SpaceJockey/MRSD-Team-B/ROS/src/spacejockey/resources/clean_map.png

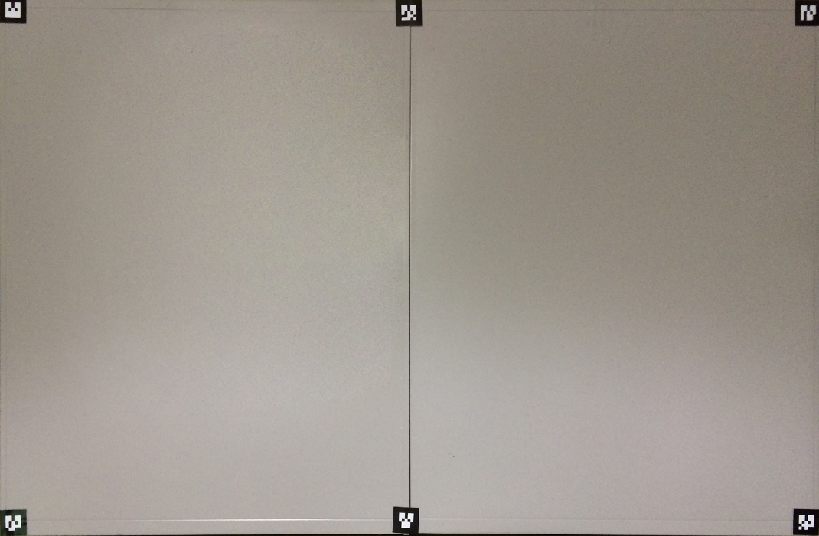
ROS/src/spacejockey/resources/clean_map.png
