SpaceJockey/MRSD-Team-B/ROS/src/spacejockey/resources/dirty_map.png

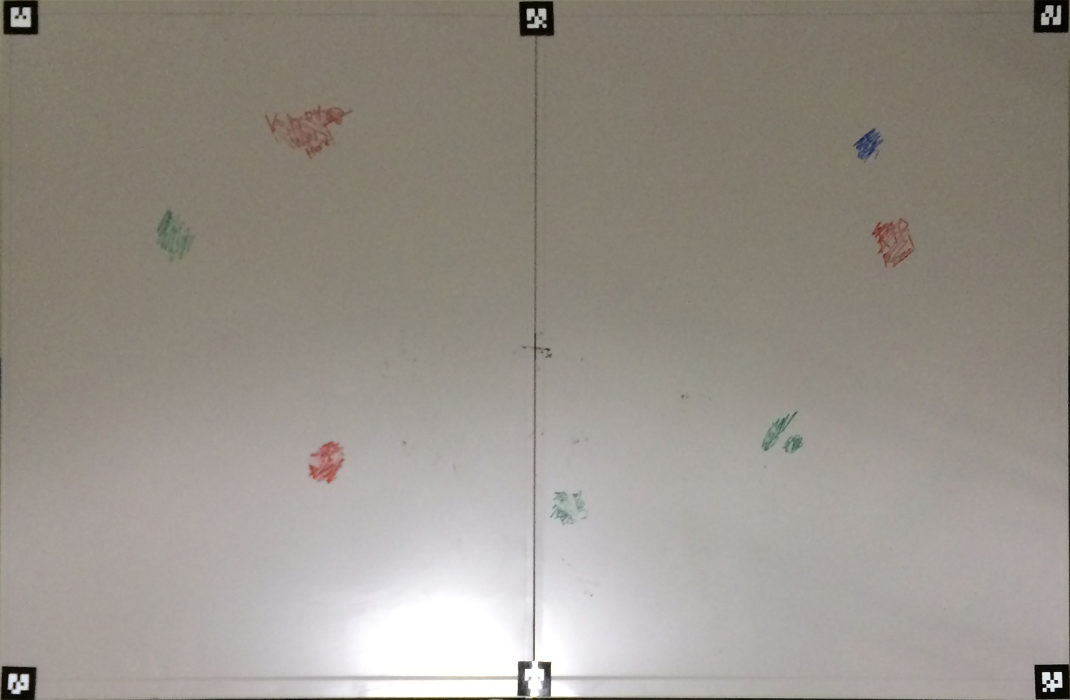
ROS/src/spacejockey/resources/dirty_map.png
