SpaceJockey/MRSD-Team-B/README.md

MRSD-Team-B
===========

The best team is sometimes the B team...
