SpaceJockey/MRSD-Team-B/CAD/Markers/mark_0_1.png

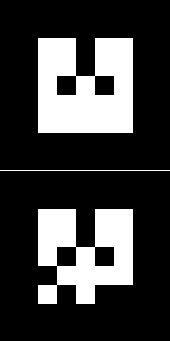
CAD/Markers/mark_0_1.png
