SpaceJockey/MRSD-Team-B/CAD/Markers/mark_2_3.png

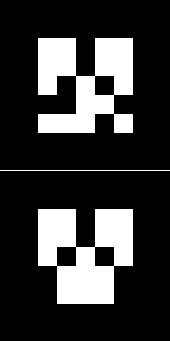
CAD/Markers/mark_2_3.png
