SpaceJockey/MRSD-Team-B/CAD/Markers/mark_4_5.png

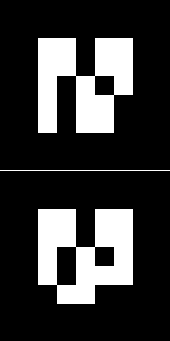
CAD/Markers/mark_4_5.png
