SpaceJockey/MRSD-Team-B/ROS/src/spacejockey/resources/ar_mask.png

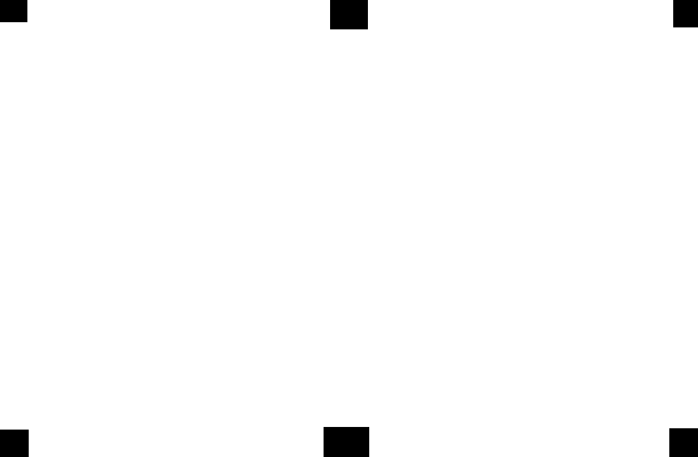
ROS/src/spacejockey/resources/ar_mask.png
