SpaceJockey/MRSD-Team-B/ROS/src/spacejockey/resources/vignette.png

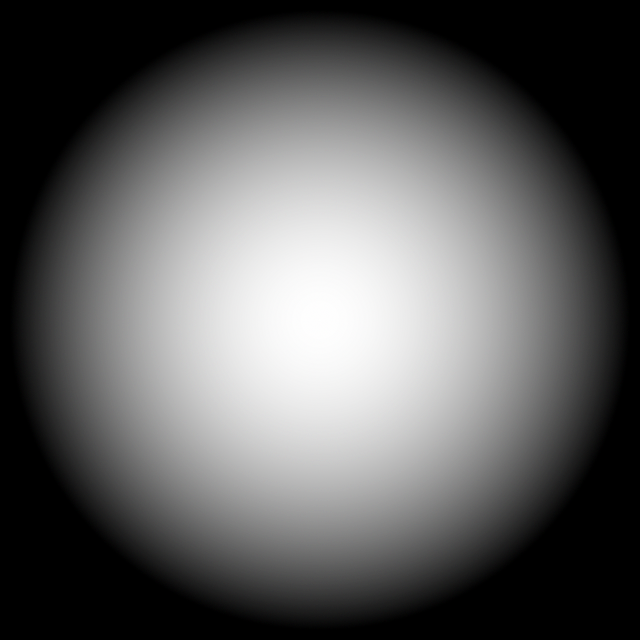
ROS/src/spacejockey/resources/vignette.png
