SpaceJockey/MRSD-Team-B/Eagle/PDM/PDM_BOM.xlsx

Qty | Label | Value | Description | Package | Digi-Key Part # | Link
8 | CAM*, DUE, SERVO* |  | Molex 5566-2 Mini FIT connector 2 poles | 5566-2 | WM3843-ND | http://www.digikey.com/product-detail/en/0039293026/WM3843-ND/2002650
10 | C1, C5-C10 | 10uF | Decoupling Capacitors | C1206K | 399-8269-1-ND | http://www.digikey.com/product-detail/en/T491A106K016AT/399-8269-1-ND/3471992
3 | D1 | 8.5V | TVS Diode | SMBJ | SMBJ8.5ALFCT-ND | http://www.digikey.com/product-detail/en/SMBJ8.5A/SMBJ8.5ALFCT-ND/762818
4 | D2 | 3.3V | Zener Diode | SOD80C | 568-6264-1-ND | http://www.digikey.com/product-detail/en/BZV55-C3V3,115/568-6264-1-ND/2531551
8 | F_* |  | Automotive Fuse Holder, PCB Mount | MINI-ATO | F065-ND | http://www.digikey.com/product-detail/en/01530008Z/F065-ND/183334
8 | LED* |  | Green Status LED | SML1206 | 160-1169-1-ND | http://www.digikey.com/product-detail/en/LTST-C150GKT/160-1169-1-ND/269241
10 | R1-6,8 | 1K | RESISTOR, American symbol | R1206 | RMCF1206JT1K00CT-ND | http://www.digikey.com/product-detail/en/RMCF1206JT1K00/RMCF1206JT1K00CT-ND/1942786
4 | R7 | 1.54K | RESISTOR, American symbol | R1206 | P1.54KFCT-ND | http://www.digikey.com/product-detail/en/ERJ-8ENF1541V/P1.54KFCT-ND/89668
5 | BATT_FUSE | 10 A | Mini Automotive Fuse | MINI-ATO | F991-ND | http://www.digikey.com/product-detail/en/0297010.WXNV/F991-ND/146591
5 | DUE_FUSE | 2 A | Mini Automotive Fuse | MINI-ATO | F986-ND | http://www.digikey.com/product-detail/en/0297002.WXNV/F986-ND/124900
5 | SERVO_FUSE | 7.5 A | Mini Automotive Fuse | MINI-ATO | F990-ND | http://www.digikey.com/product-detail/en/029707.5WXNV/F990-ND/146586
2 | BATT* |  | XT60 Hobby LiPo Connector (Amazon) | XT60 Connector | N/A | N/A
1 | BAT_MON |  | .025" post Header (MRSD Stock) | TSW-101-02-S-S | N/A | N/A
2 | C2-3 | 330uF 10V | Electrolytic Capacitor (in MRSD Stock) | TT5D11 | N/A | N/A
N/A | U1-3 |  | L7805 Regulator (MRSD Stock) | TO-220 | N/A | N/A
