SpaceJockey/MRSD-Team-B/CAD/SolidWorks/Chassis Parts/CenterJoint.SLDASM

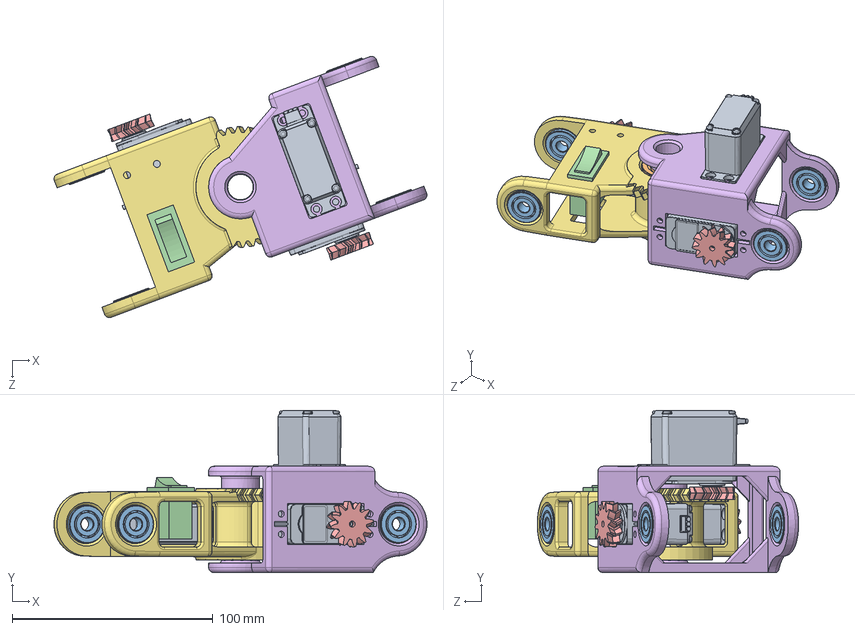
[picture p8: CAD file, 2014-05-08]
CAD/SolidWorks/Chassis Parts/CenterJoint.SLDASM
185.8 x 80.7 x 130.2 mm
Hitec HS-5496 x 3
6455K230 x 2
6455K130 x 4
1091-1013-ND
VGearServo x 3
CenterJointB
CenterJoinA
