SpaceJockey/MRSD-Team-B/CAD/SolidWorks/Linear Actuator/RackShaft.SLDASM

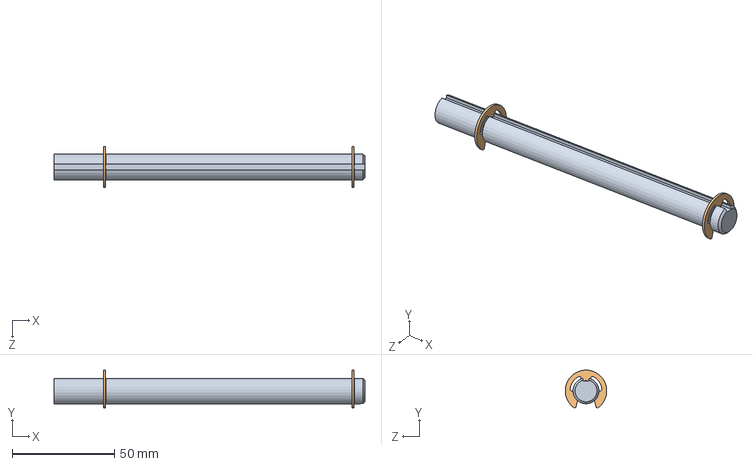
[picture p9: CAD file, 2014-05-08]
CAD/SolidWorks/Linear Actuator/RackShaft.SLDASM
152.4 x 18.5 x 20.3 mm
1570K420
97431A340 x 2
