SpaceJockey/MRSD-Team-B/CAD/SolidWorks/Space Jockey.SLDASM

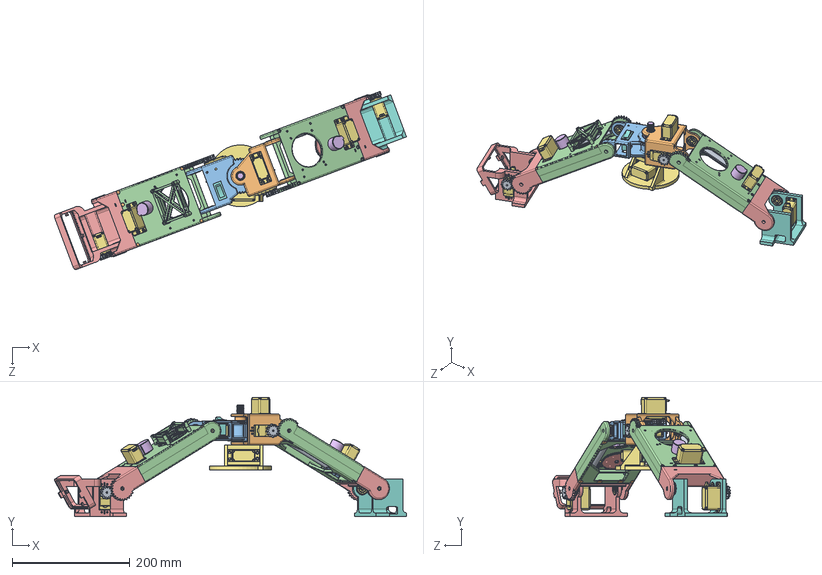
[picture p10: CAD file, 2014-05-08]
CAD/SolidWorks/Space Jockey.SLDASM
598.2 x 202.5 x 303.0 mm
1570K420 x 2
97431A340 x 4
5986K767 x 2
RSA48-HMG-36 x 2
SPBD48-24-96 x 2
3547S-1AA-502A-ND x 2
Hitec HS-5496 x 8
5986K66 x 2
1257K650 x 2
FixedEndJoin x 2
FreeEndJoin x 2
6455K230 x 2
6455K130 x 8
1091-1013-ND
VGearServo x 5
CenterJointB
CenterJoinA
BatteryBox x 2
CameraFoot
CenterFootAss^CenterFoot
EndFootB
