SpaceJockey/MRSD-Team-B/CAD/SolidWorks/Chassis Parts/BatteryBox.SLDASM

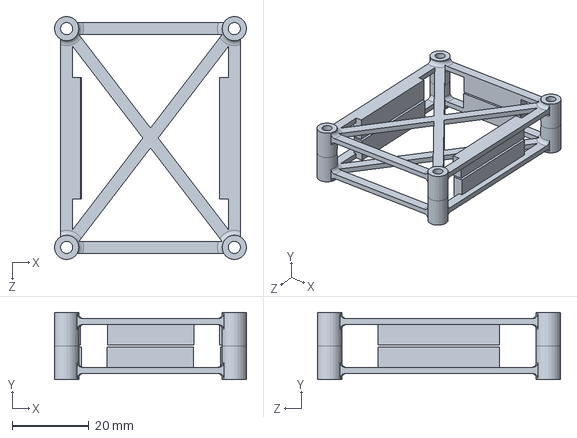
[picture p11: CAD file, 2014-05-08]
CAD/SolidWorks/Chassis Parts/BatteryBox.SLDASM
50.2 x 17.5 x 63.5 mm
BatteryBox x 2
