SpaceJockey/MRSD-Team-B/CAD/SolidWorks/Linear Actuator/FreeEndJoin.SLDASM

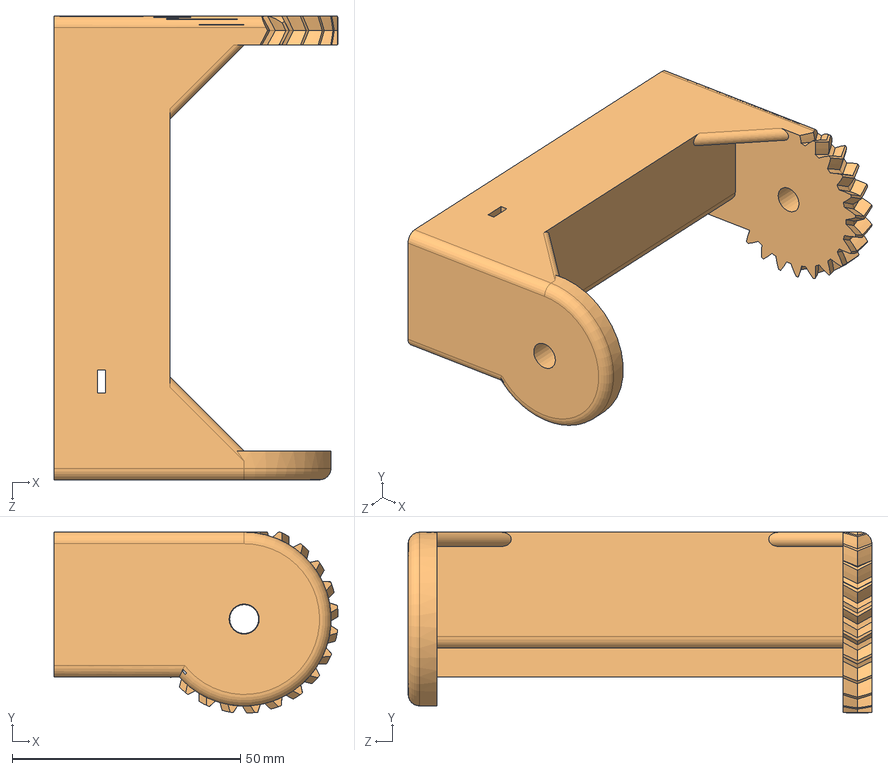
[picture p12: CAD file, 2014-05-08]
CAD/SolidWorks/Linear Actuator/FreeEndJoin.SLDASM
62.2 x 39.6 x 101.6 mm
