SpaceJockey/MRSD-Team-B/CAD/SolidWorks/Chassis Parts/CenterFoot.SLDASM

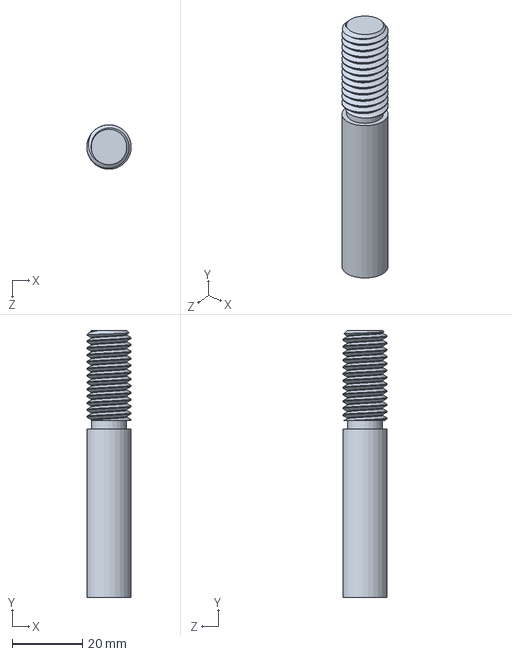
[picture p13: CAD file, 2014-05-07]
CAD/SolidWorks/Chassis Parts/CenterFoot.SLDASM
12.7 x 76.2 x 12.7 mm
