SpaceJockey/MRSD-Team-B/CAD/SolidWorks/Linear Actuator/Actuator.SLDASM

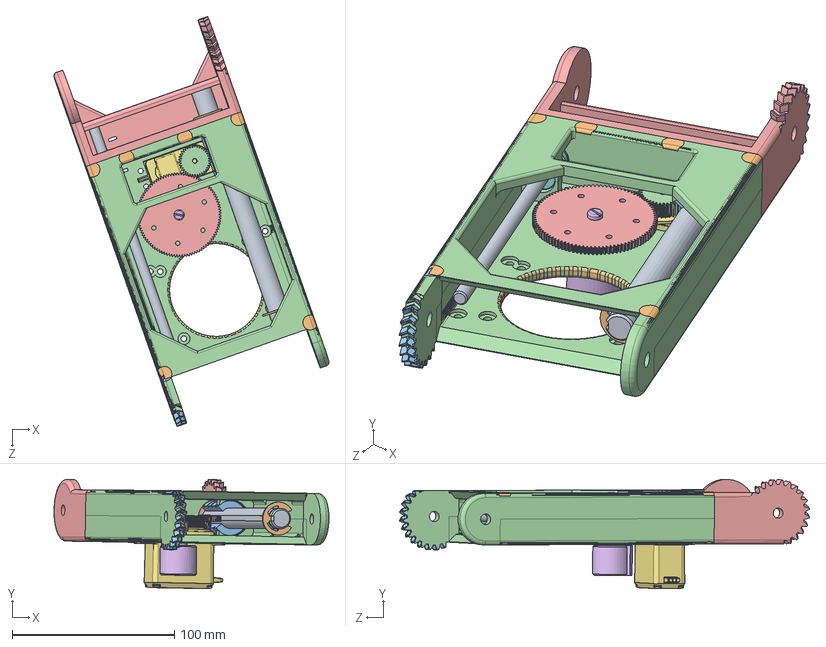
[picture p14: CAD file, 2014-05-08]
CAD/SolidWorks/Linear Actuator/Actuator.SLDASM
169.3 x 67.3 x 252.5 mm
1570K420
97431A340 x 2
5986K767
RSA48-HMG-36
SPBD48-24-96
3547S-1AA-502A-ND
Hitec HS-5496
5986K66
1257K650
FixedEndJoin
FreeEndJoin
