SpaceJockey/MRSD-Team-B/CAD/SolidWorks/Linear Actuator/FixedEndJoin.SLDASM

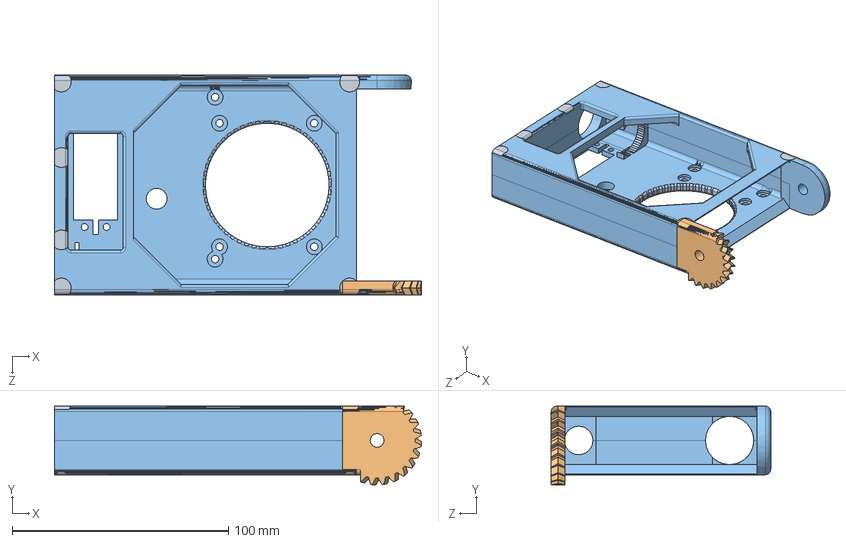
[picture p15: CAD file, 2014-04-10]
CAD/SolidWorks/Linear Actuator/FixedEndJoin.SLDASM
169.8 x 36.4 x 101.6 mm
