SpaceJockey/MRSD-Team-B/CAD/SolidWorks/Linear Actuator/FixedEndSplit.sldasm

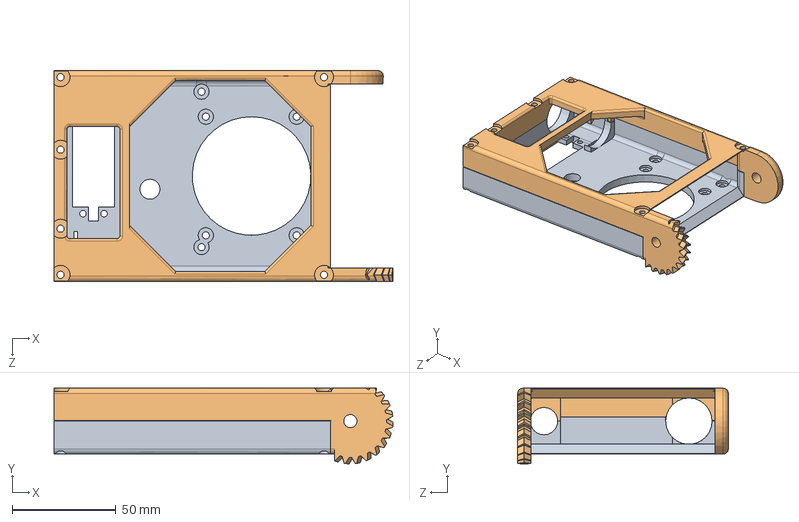
[picture p16: CAD file, 2014-03-10]
CAD/SolidWorks/Linear Actuator/FixedEndSplit.sldasm
163.4 x 36.4 x 101.6 mm
Top
Bottom
