SpaceJockey/MRSD-Team-B/CAD/SolidWorks/Chassis Parts/CenterJoinA.SLDASM

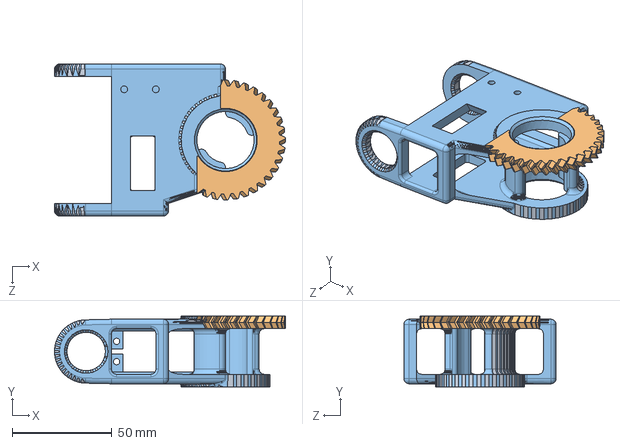
[picture p17: CAD file, 2014-03-31]
CAD/SolidWorks/Chassis Parts/CenterJoinA.SLDASM
115.8 x 35.6 x 76.2 mm
