SpaceJockey/MRSD-Team-B/CAD/SolidWorks/Test Parts/6-32-size.SLDPRT

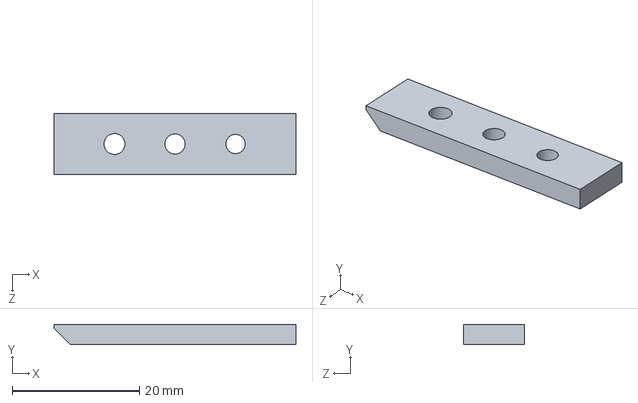
[picture p18: CAD file, 2014-03-10]
CAD/SolidWorks/Test Parts/6-32-size.SLDPRT
38.1 x 3.17 x 9.53 mm
