SpaceJockey/MRSD-Team-B/Eagle/PDM/Gerbers/GerbMerge/TeamB/TeamB.dxf

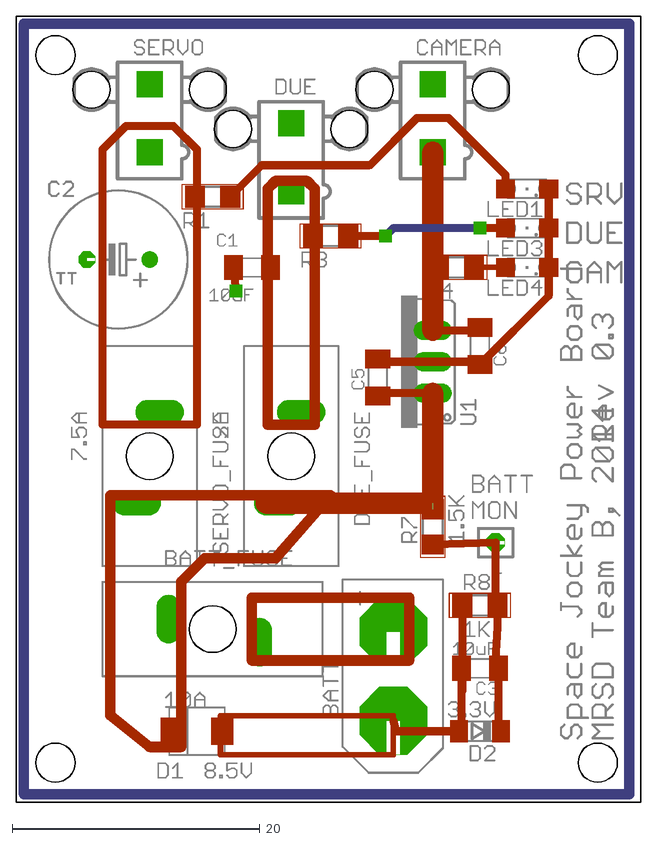
[picture p19: CAD file, 2014-02-17]
Eagle/PDM/Gerbers/GerbMerge/TeamB/TeamB.dxf
50.5 x 63.5
