SpaceJockey/MRSD-Team-B/CAD/SolidWorks/Test Parts/JointStub.SLDPRT

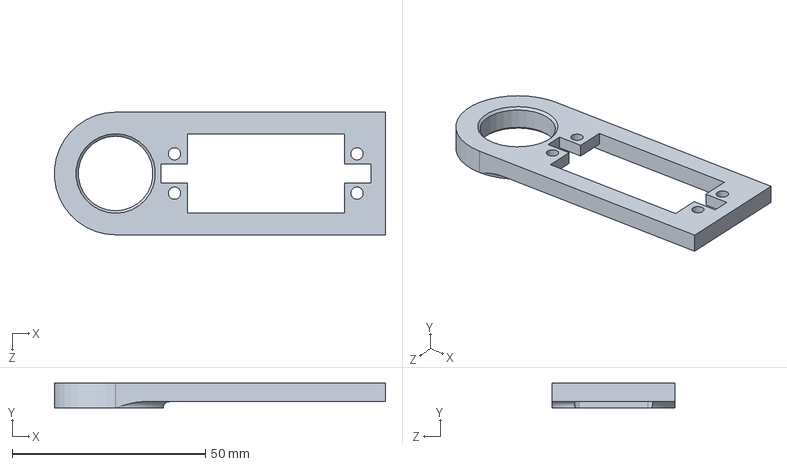
[picture p20: CAD file, 2014-03-10]
CAD/SolidWorks/Test Parts/JointStub.SLDPRT
85.7 x 6.35 x 31.8 mm
