SpaceJockey/MRSD-Team-B/CAD/SolidWorks/Chassis Parts/EndFoot.SLDPRT

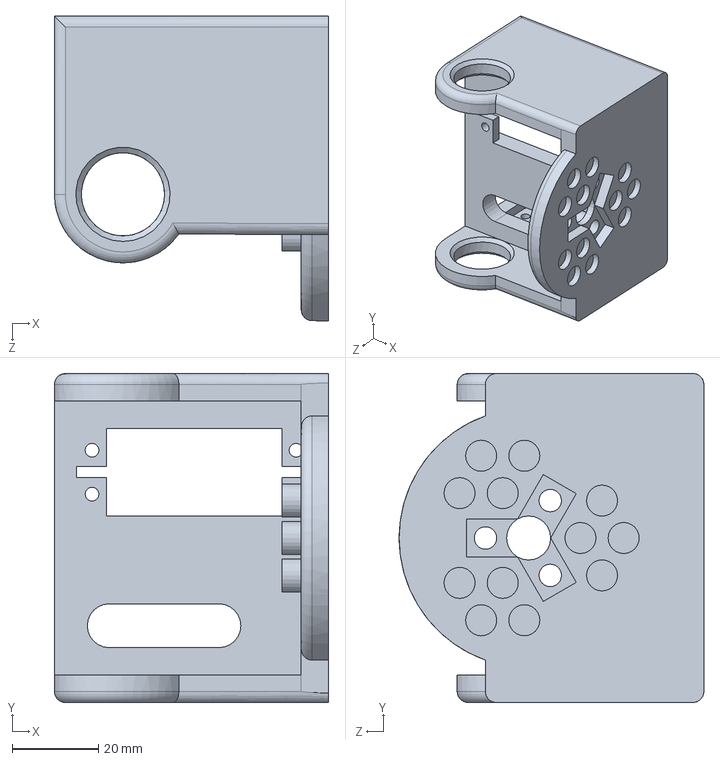
[picture p21: CAD file, 2014-04-28]
CAD/SolidWorks/Chassis Parts/EndFoot.SLDPRT
63.5 x 76.2 x 70.6 mm
