SpaceJockey/MRSD-Team-B/CAD/SolidWorks/Linear Actuator/FixedEnd.SLDPRT

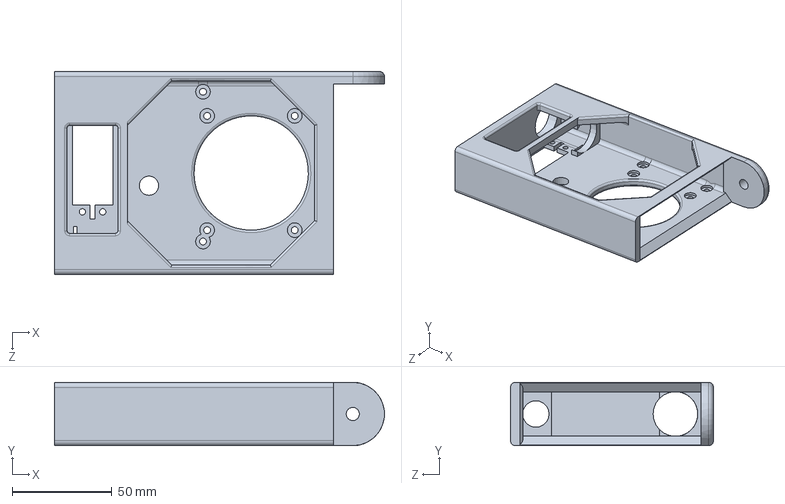
[picture p22: CAD file, 2014-04-10]
CAD/SolidWorks/Linear Actuator/FixedEnd.SLDPRT
165.1 x 31.8 x 101.6 mm
