SpaceJockey/MRSD-Team-B/CAD/SolidWorks/Chassis Parts/EndFootB.SLDPRT

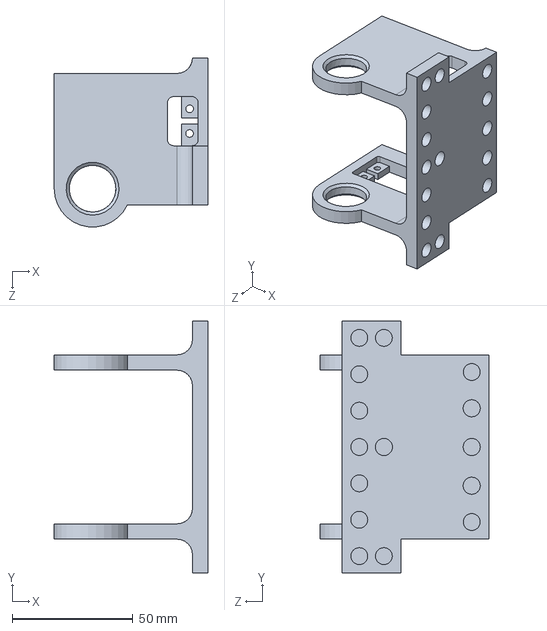
[picture p23: CAD file, 2014-04-28]
CAD/SolidWorks/Chassis Parts/EndFootB.SLDPRT
63.5 x 104.1 x 69.8 mm
