SpaceJockey/MRSD-Team-B/CAD/SolidWorks/Linear Actuator/Top.sldprt

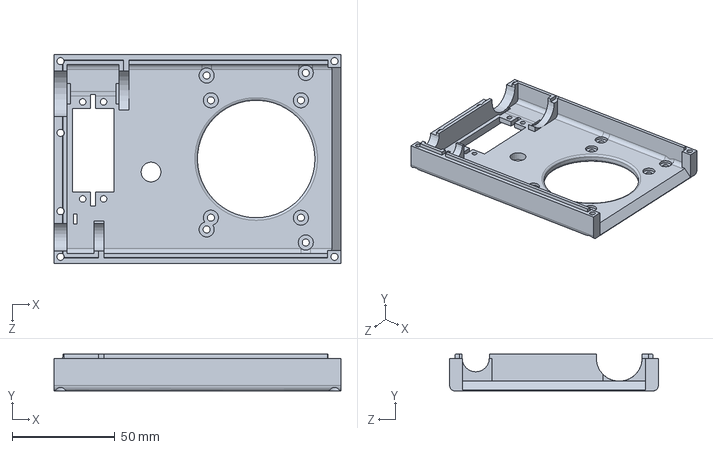
[picture p24: CAD file, 2014-04-10]
CAD/SolidWorks/Linear Actuator/Top.sldprt
139.7 x 17.9 x 101.6 mm
