SpaceJockey/MRSD-Team-B/CAD/SolidWorks/Chassis Parts/TriPeg.SLDPRT

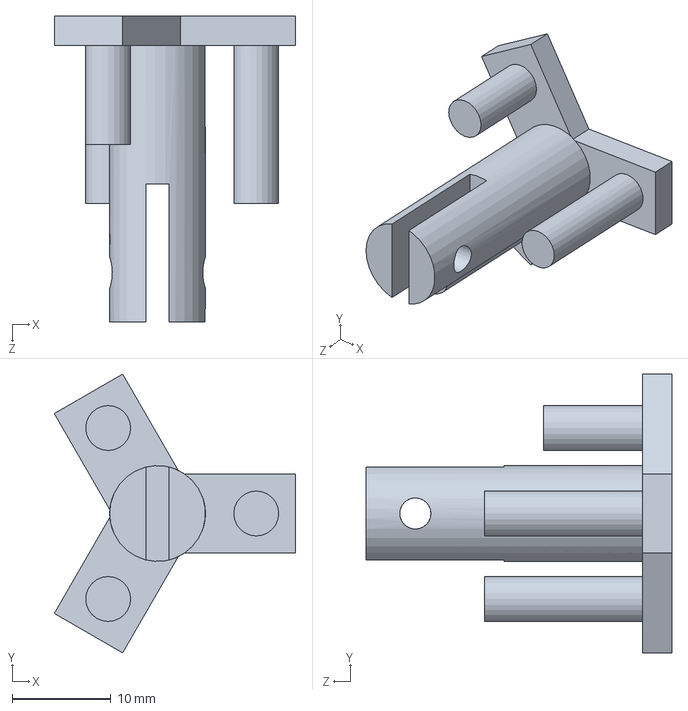
[picture p25: CAD file, 2014-04-28]
CAD/SolidWorks/Chassis Parts/TriPeg.SLDPRT
24.5 x 28.2 x 31.0 mm
