SpaceJockey/MRSD-Team-B/CAD/SolidWorks/Linear Actuator/FreeEnd.SLDPRT

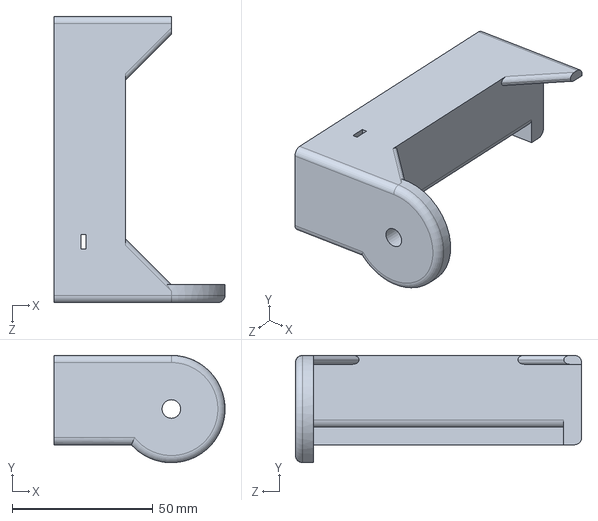
[picture p26: CAD file, 2014-04-05]
CAD/SolidWorks/Linear Actuator/FreeEnd.SLDPRT
60.7 x 38.1 x 101.6 mm
