SpaceJockey/MRSD-Team-B/CAD/SolidWorks/Chassis Parts/Peg4.SLDPRT

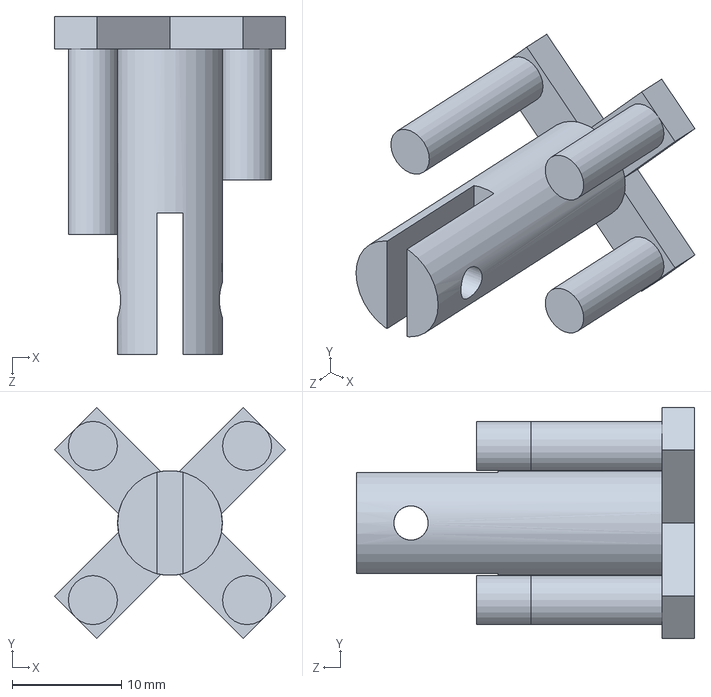
[picture p27: CAD file, 2014-04-28]
CAD/SolidWorks/Chassis Parts/Peg4.SLDPRT
21.2 x 21.2 x 31.0 mm
