SpaceJockey/MRSD-Team-B/CAD/SolidWorks/Linear Actuator/Bottom.sldprt

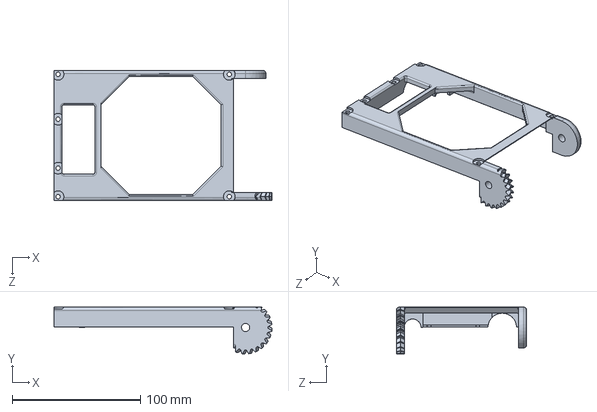
[picture p28: CAD file, 2014-04-05]
CAD/SolidWorks/Linear Actuator/Bottom.sldprt
169.8 x 36.4 x 101.6 mm
