SpaceJockey/MRSD-Team-B/CAD/SolidWorks/Chassis Parts/CameraMount.SLDPRT

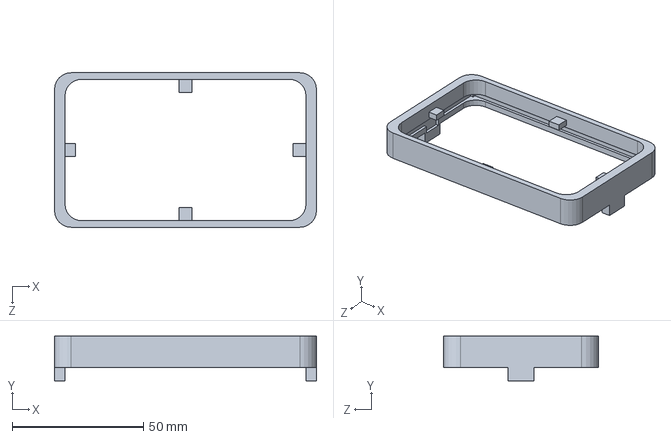
[picture p29: CAD file, 2014-04-28]
CAD/SolidWorks/Chassis Parts/CameraMount.SLDPRT
100.0 x 17.0 x 59.0 mm
