SpaceJockey/MRSD-Team-B/CAD/SolidWorks/Chassis Parts/CameraFoot.SLDPRT

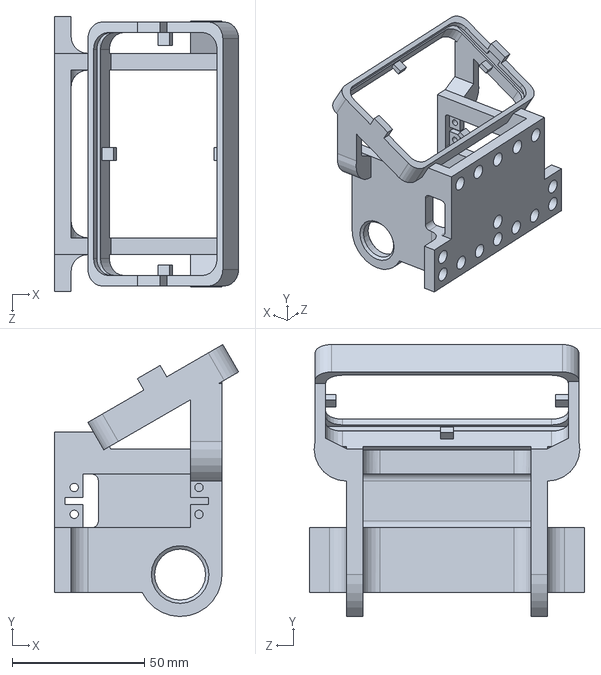
[picture p30: CAD file, 2014-04-28]
CAD/SolidWorks/Chassis Parts/CameraFoot.SLDPRT
69.8 x 103.0 x 104.1 mm
