SpaceJockey/MRSD-Team-B/CAD/SolidWorks/Chassis Parts/CenterJointA.SLDPRT

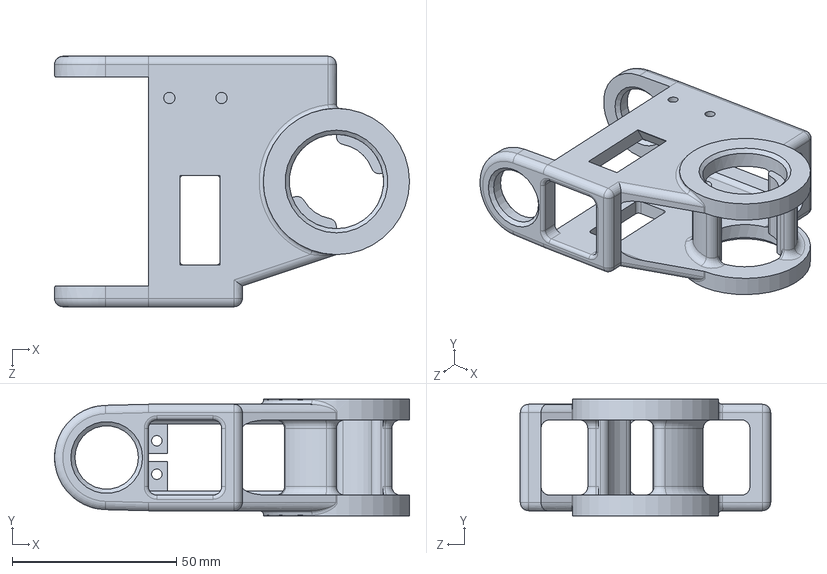
[picture p31: CAD file, 2014-03-31]
CAD/SolidWorks/Chassis Parts/CenterJointA.SLDPRT
107.9 x 35.6 x 76.2 mm
