SpaceJockey/MRSD-Team-B/CAD/SolidWorks/Chassis Parts/CenterJointB.SLDPRT

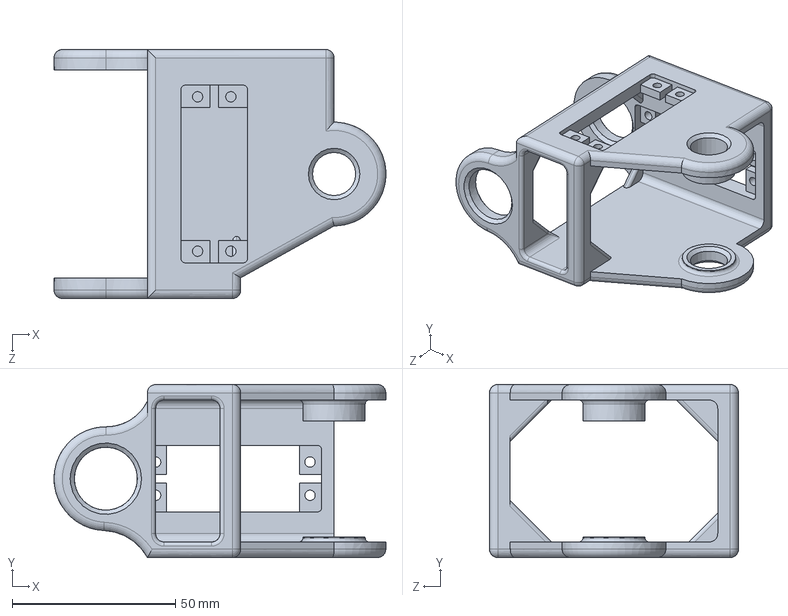
[picture p32: CAD file, 2014-03-12]
CAD/SolidWorks/Chassis Parts/CenterJointB.SLDPRT
101.6 x 53.0 x 76.2 mm
