SpaceJockey/MRSD-Team-B/(list of files, cad)

Other CAD files:
CAD/SolidWorks/Linear Actuator/TrimmedShaft.SLDASM
CAD/SolidWorks/Chassis Parts/BatteryBox.SLDPRT
CAD/SolidWorks/Chassis Parts/CenterJoinA.sldprt
CAD/SolidWorks/Chassis Parts/ScrewStub.SLDPRT
CAD/SolidWorks/Chassis Parts/Wood Washer.SLDPRT
CAD/SolidWorks/Linear Actuator/FixedEndJoin.sldprt
CAD/SolidWorks/Linear Actuator/FreeEndJoin.sldprt
CAD/SolidWorks/Linear Actuator/TrimmedShaft.SLDDRW
