SpaceJockey/MRSD-Team-B/Eagle/PDM/PDM.brd

## EAGLE design Eagle/PDM/PDM.brd (2014-02-17)

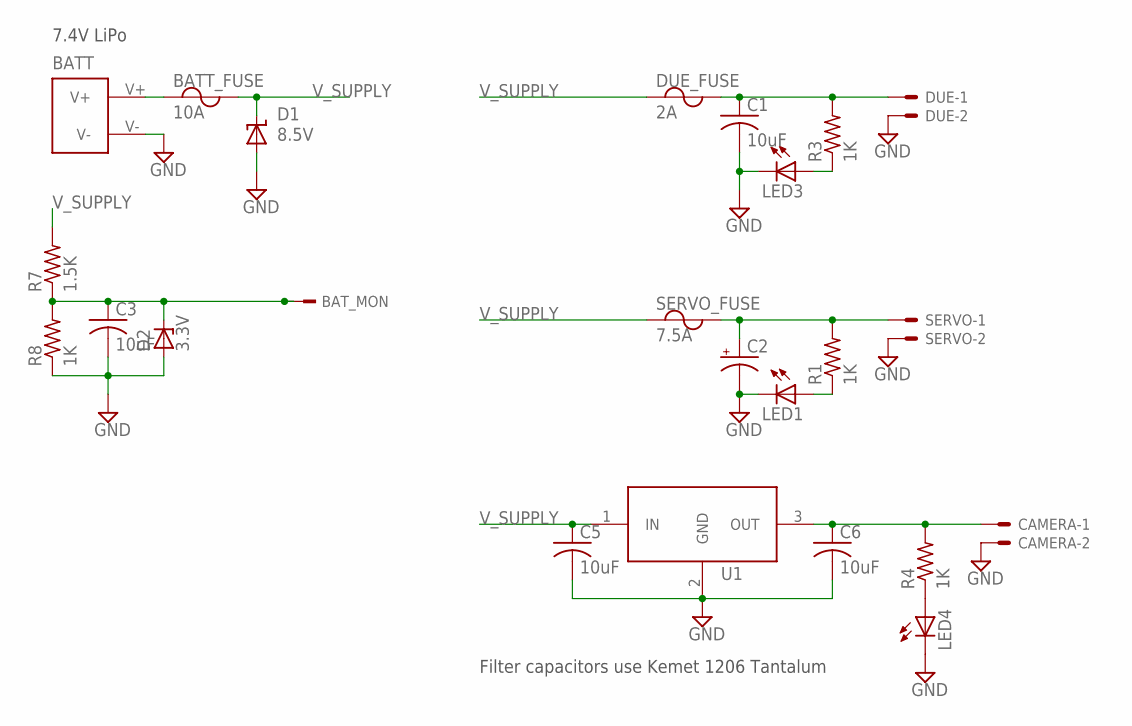
[picture p33: schematic PDM.sch]

Parts:
BATT: CON_XT60-; CON_XT60_PCB_MALE
BATT_FUSE: 10A; MINI_ATO
BAT_MON: TSW-101-02-S-S
C1, C3, C5, C6: 10uF; C1206K
C2: CPOL-USTT5D11; TT5D11
CAMERA: 5566-2
D1: 8.5V; SMBJ
D2: 3.3V; SOD80C
DUE: 5566-2
DUE_FUSE: 2A; MINI_ATO
LED1, LED3, LED4: LEDSML1206; SML1206
R1, R3, R4, R8: 1K; R1206
R7: 1.5K; R1206
SERVO: 5566-2
SERVO_FUSE: 7.5A; MINI_ATO
U1: MIC29150/29300/29500VERTICAL; TO220V

Connections:
GND: BATT.V-, C1.2, C2.-, C3.2, C5.2, C6.2, CAMERA.2, D1.A, D2.A, DUE.2, LED1.C, LED3.C, LED4.C, R8.1, SERVO.2, U1.2 (GND)
unnamed: BATT.V+, BATT_FUSE.P$2 (1)
unnamed: C1.1, DUE.1, DUE_FUSE.P$3 (2), R3.2
unnamed: LED1.A, R1.1
unnamed: C6.1, CAMERA.1, R4.2, U1.3 (OUT)
unnamed: LED3.A, R3.1
unnamed: LED4.A, R4.1
unnamed: C2.+, R1.2, SERVO.1, SERVO_FUSE.P$3 (2)
unnamed: BAT_MON.1, C3.1, D2.C, R7.1, R8.2
V_SUPPLY: BATT_FUSE.P$3 (2), C5.1, D1.C, DUE_FUSE.P$2 (1), R7.2, SERVO_FUSE.P$2 (1), U1.1 (IN)

Notes on the sheet:
Filter capacitors use Kemet 1206 Tantalum
7.4V LiPo

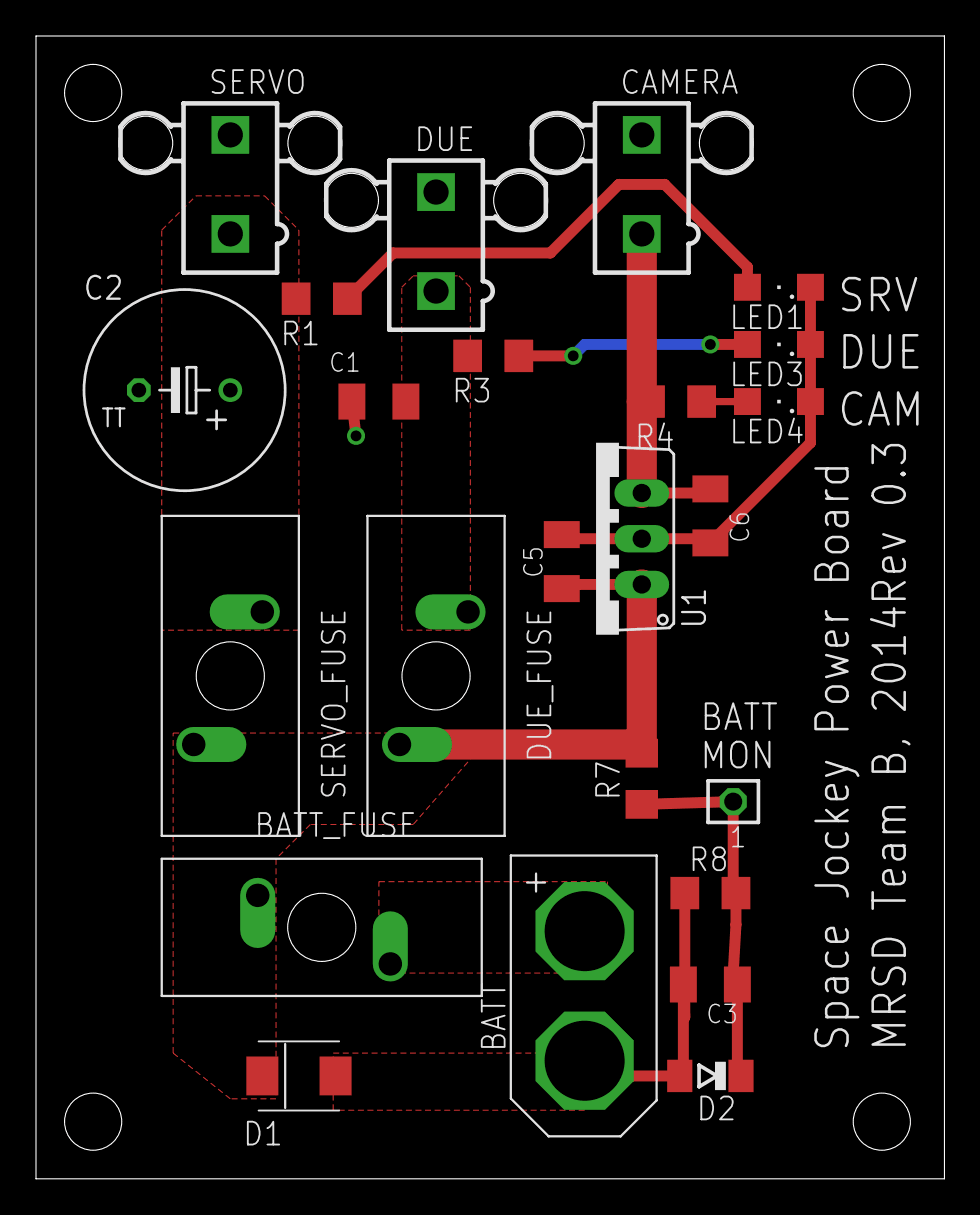
[picture p34: board PDM.brd from above]

Board: 2 copper layers, 50.5 x 63.5 mm, 24 parts (0 on the bottom side), 10 nets.
