SpaceJockey/MRSD-Team-B/Project Course/Task 10 Power Distribution Board/powerdist2.brd

## EAGLE design Project Course/Task 10 Power Distribution Board/powerdist2.brd (2013-10-21)

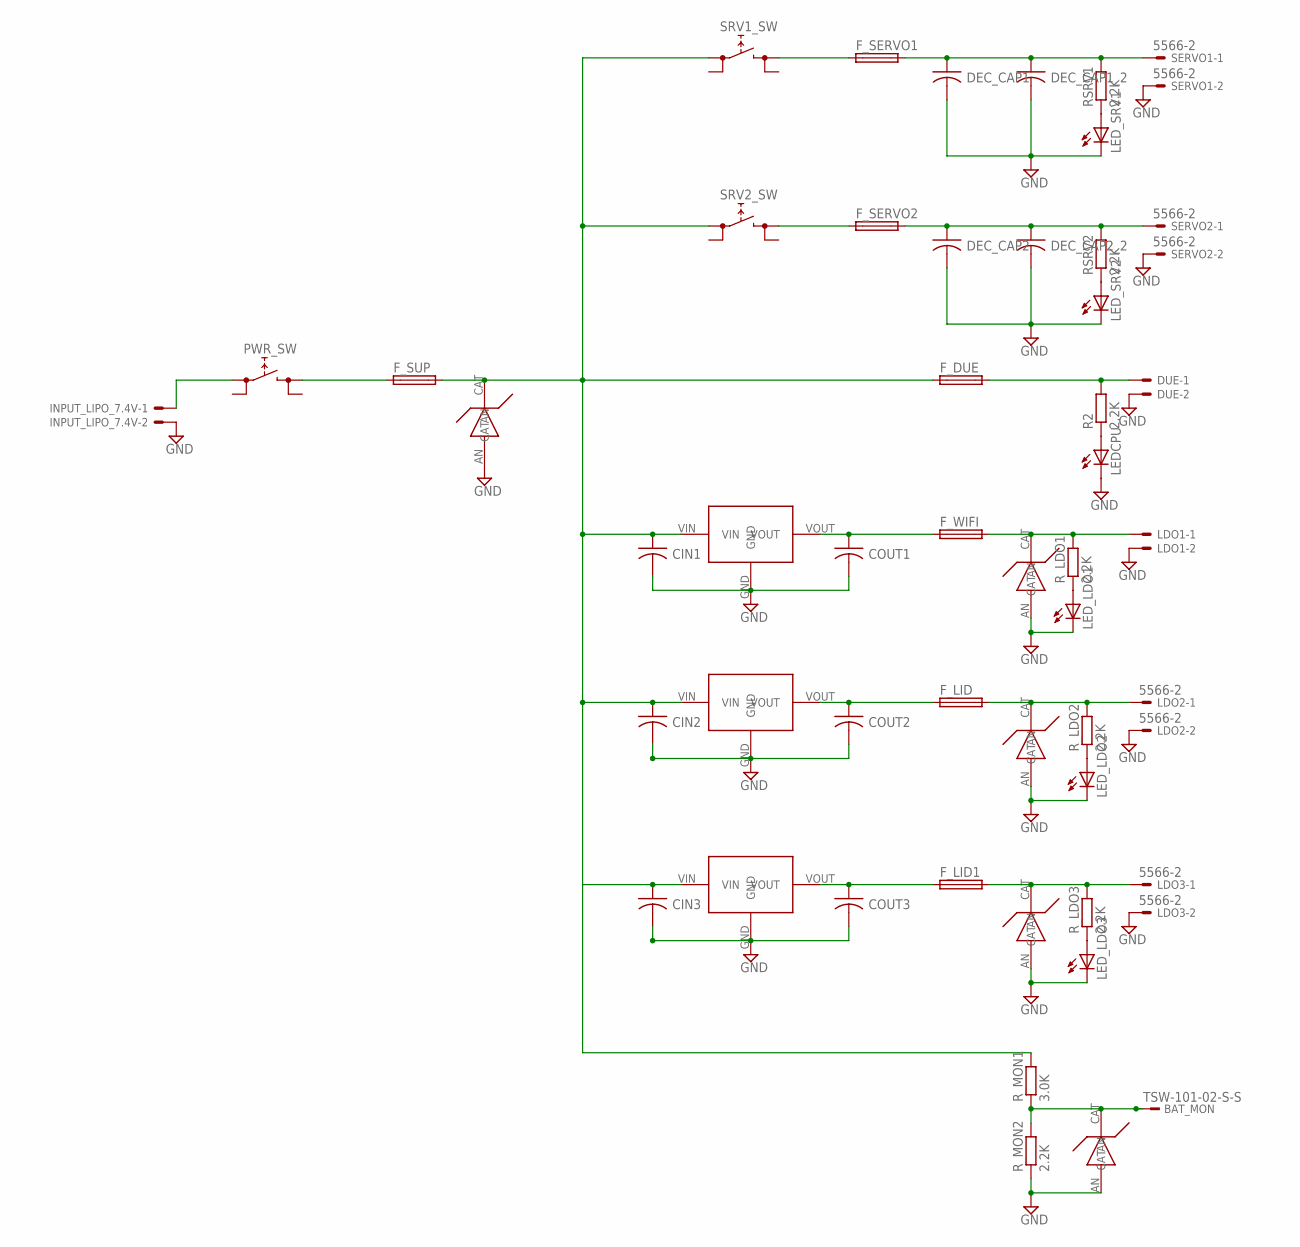
[picture p35: schematic powerdist2.sch]

Parts:
BAT_MON: TSW-101-02-S-S
CIN1, CIN2, CIN3: CAPACITORTH_CAP; C025-025X050
COUT1, COUT2, COUT3: CAPACITORTH_CAP; C025-025X050
DEC_CAP1, DEC_CAP1_2, DEC_CAP2, DEC_CAP2_2: CAPACITORTH_CAP; C025-025X050
DUE: C-GRID-02-70553; 70553-02
F_DUE: GSH15
F_LID, F_LID1: GSH15
F_SERVO1, F_SERVO2: GSH15
F_SUP: GSH15
F_WIFI: GSH15
INPUT_LIPO_7.4V: 22-23-2021
LDO1: C-GRID-02-70553; 70553-02
LDO2, LDO3: 5566-2
LEDCPU: LEDCHIP-LED0805; CHIP-LED0805
LED_LDO1, LED_LDO2, LED_LDO3: LEDCHIP-LED0805; CHIP-LED0805
LED_SRV1, LED_SRV2: LEDCHIP-LED0805; CHIP-LED0805
LID12V1A, LID12V1A1: MIC29150/29300/29500
PWR_SW: REKN
R2: 2.2K; R0402
RSRV1, RSRV2: 2.2K; R0402
R_LDO1, R_LDO2, R_LDO3: 2.2K; R0402
R_MON1: 3.0K; R0402
R_MON2: 2.2K; R0402
SERVO1, SERVO2: 5566-2
SRV1_SW, SRV2_SW: REKN
TVS-MAIN: 26V; TVS-SMAJ
TVS-MAIN1, TVS-MAIN3: 16V; TVS-SMAJ
TVS-MAIN2: 5V; TVS-SMAJ
TVS_3.3: 16V; TVS-SMAJ
WIFI5V1A1: MIC29150/29300/29500

Connections:
GND: CIN1.2, CIN2.2, CIN3.2, COUT1.2, COUT2.2, COUT3.2, DEC_CAP1.2, DEC_CAP1_2.2, DEC_CAP2.2, DEC_CAP2_2.2, DUE.2, INPUT_LIPO_7.4V.2, LDO1.2, LDO2.2, LDO3.2, LEDCPU.C, LED_LDO1.C, LED_LDO2.C, LED_LDO3.C, LED_SRV1.C, LED_SRV2.C, LID12V1A.GND, LID12V1A1.GND, R_MON2.1, SERVO1.2, SERVO2.2, TVS-MAIN.AN, TVS-MAIN1.AN, TVS-MAIN2.AN, TVS-MAIN3.AN, TVS_3.3.AN, WIFI5V1A1.GND
unnamed: DEC_CAP2.1, DEC_CAP2_2.1, F_SERVO2.2, RSRV2.2, SERVO2.1
unnamed: F_LID.2, LDO2.1, R_LDO2.2, TVS-MAIN3.CAT
unnamed: F_SERVO1.1, SRV1_SW.1A (1)
unnamed: DUE.1, F_DUE.2, R2.2
unnamed: LED_SRV2.A, RSRV2.1
unnamed: COUT1.1, F_WIFI.1, WIFI5V1A1.VOUT
unnamed: F_WIFI.2, LDO1.1, R_LDO1.2, TVS-MAIN2.CAT
unnamed: LEDCPU.A, R2.1
unnamed: COUT2.1, F_LID.1, LID12V1A.VOUT
unnamed: INPUT_LIPO_7.4V.1, PWR_SW.0A (0)
unnamed: LED_LDO1.A, R_LDO1.1
unnamed: CIN1.1, CIN2.1, F_DUE.1, F_SUP.2, LID12V1A.VIN, R_MON1.2, SRV1_SW.0A (0), SRV2_SW.0A (0), TVS-MAIN.CAT, WIFI5V1A1.VIN
unnamed: LED_LDO2.A, R_LDO2.1
unnamed: F_SUP.1, PWR_SW.1A (1)
unnamed: DEC_CAP1.1, DEC_CAP1_2.1, F_SERVO1.2, RSRV1.2, SERVO1.1
unnamed: LED_SRV1.A, RSRV1.1
unnamed: F_SERVO2.1, SRV2_SW.1A (1)
unnamed: BAT_MON.1, R_MON1.1, R_MON2.2, TVS_3.3.CAT
unnamed: COUT3.1, F_LID1.1, LID12V1A1.VOUT
unnamed: CIN3.1, LID12V1A1.VIN
unnamed: F_LID1.2, LDO3.1, R_LDO3.2, TVS-MAIN1.CAT
unnamed: LED_LDO3.A, R_LDO3.1

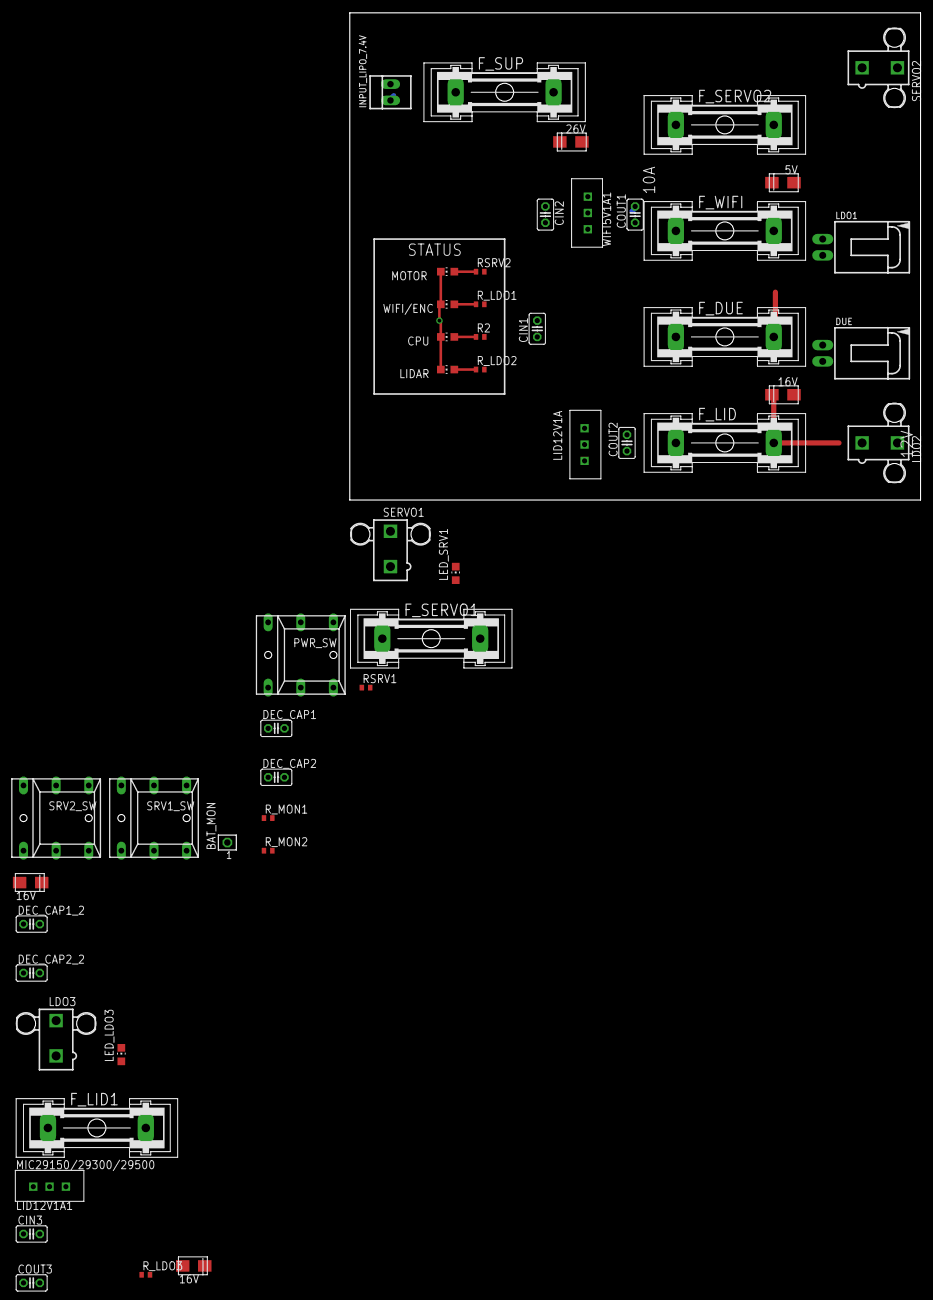
[picture p36: board powerdist2.brd from above]

Board: 2 copper layers, 88.9 x 75.9 mm, 50 parts (0 on the bottom side), 23 nets.
