SpaceJockey/MRSD-Team-B/Eagle/PDM/Gerbers/GerbMerge/TeamE/TeamE.brd

## EAGLE design Eagle/PDM/Gerbers/GerbMerge/TeamE/TeamE.brd (2014-02-17)

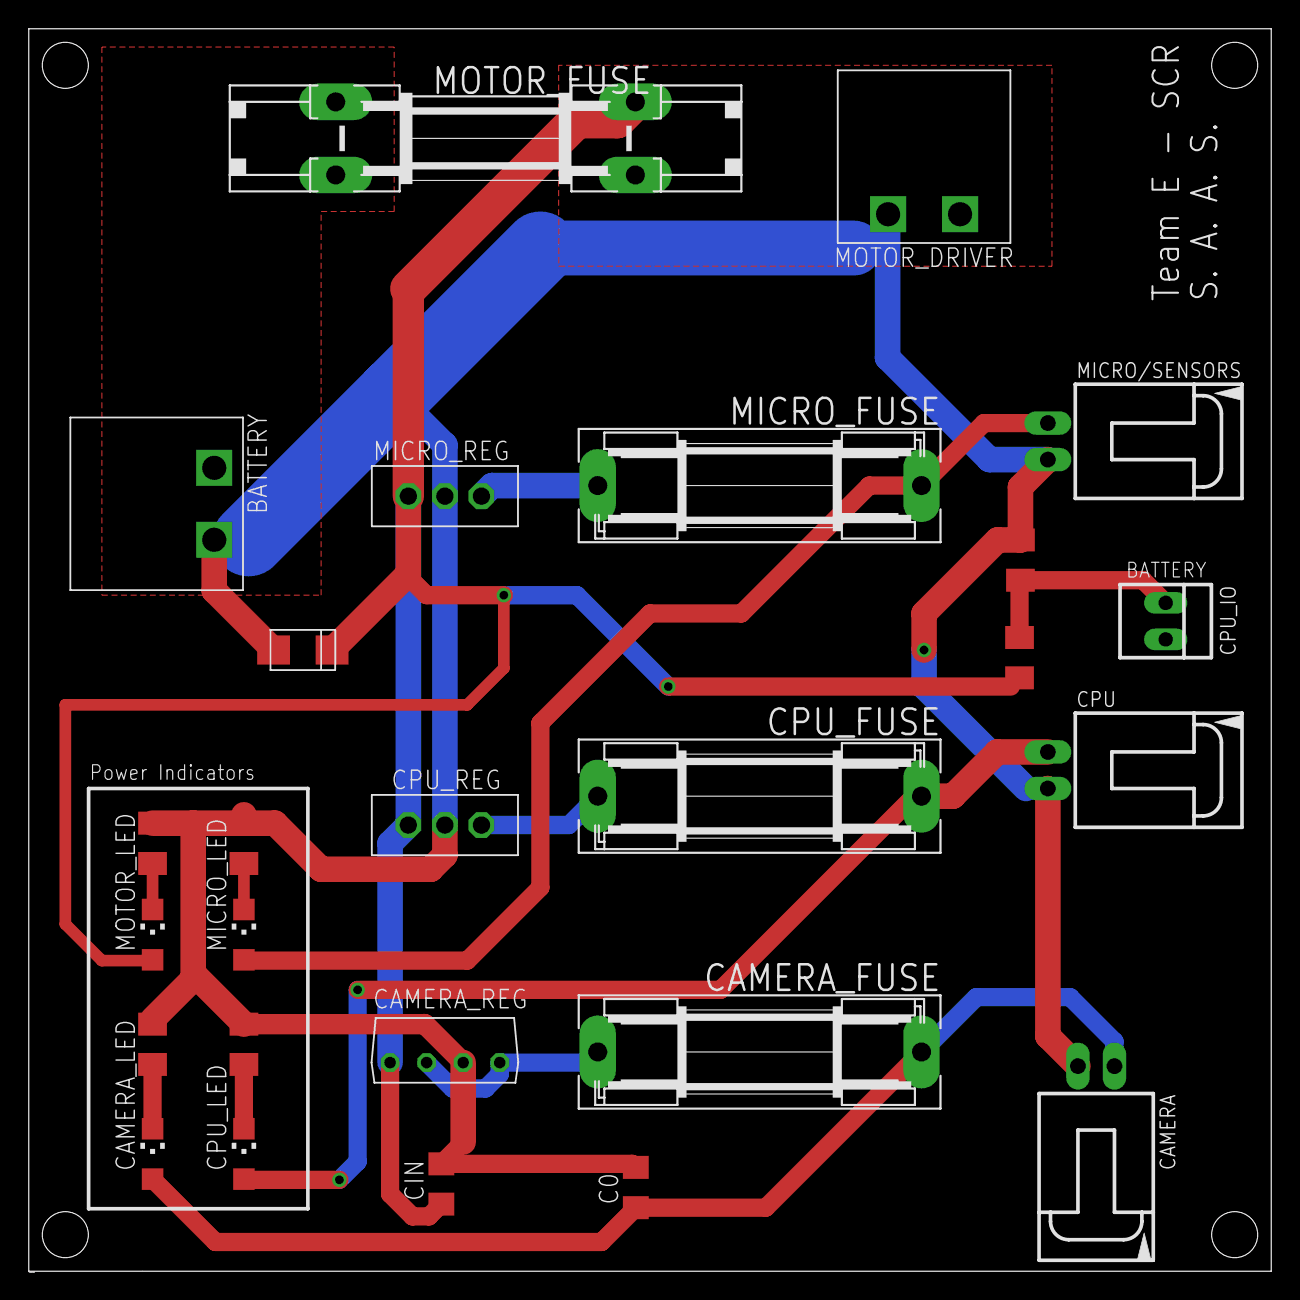
[picture p37: board TeamE.brd from above]

Board: 2 copper layers, 86.4 x 86.4 mm, 26 parts (0 on the bottom side), 14 nets.

Parts:
BATTERY: TERMINAL-BLOCK; TERM-BLOCK
C0: 47 uF; C1206
CAMERA: C-GRID-02-70553; 70553-02
CAMERA_FUSE: 2.5A; SH22,5
CAMERA_LED: GREEN; CHIPLED_1206
CAMERA_REG: 12V-REGULATOR-2A; PQ05RD21
CIN: 33 uF; C1206
CPU: C-GRID-02-70553; 70553-02
CPU_FUSE: 1.5A; SH22,5
CPU_IO: 22-23-2021
CPU_LED: YELLOW; CHIPLED_1206
CPU_REG: 5V-REGULATOR-1.5A; TO-220
MICRO/SENSORS: C-GRID-02-70553; 70553-02
MICRO_FUSE: 1.5A; SH22,5
MICRO_LED: RED; CHIPLED_1206
MICRO_REG: 8V-REGULATOR-1.5A; TO-220
MOTOR_DRIVER: TERMINAL-BLOCK; TERM-BLOCK
MOTOR_FUSE: 16A; SHKOG
MOTOR_LED: BLUE; CHIPLED_1206
R1: 1k; M1206
R2, R3: 500; M1206
R4, R6: 2k; M1206
R5: 4.2k; M1206
SYS_DIODE: 17V-TVS-B; SMA

Connections:
GND: BATTERY.MINUS, C0.2, CAMERA.2, CAMERA_REG.GND, CIN.2, CPU.2, CPU_REG.GND, MICRO/SENSORS.2, MICRO_REG.GND, MOTOR_DRIVER.MINUS, R1.2, R2.2, R3.2, R4.1, R6.2, SYS_DIODE.CATHODE
unnamed: CPU_IO.1, R5.2, R6.1
unnamed: CAMERA_LED.C, R1.1
unnamed: MICRO_LED.C, R2.1
unnamed: CPU_LED.C, R3.1
unnamed: MOTOR_LED.C, R4.2
unnamed: CPU_FUSE.2, CPU_REG.OUTPUT
unnamed: CPU.1, CPU_FUSE.1, CPU_LED.A
unnamed: MICRO_FUSE.2, MICRO_REG.OUTPUT
unnamed: MICRO/SENSORS.1, MICRO_FUSE.1, MICRO_LED.A
unnamed: C0.1, CAMERA.1, CAMERA_FUSE.1, CAMERA_LED.A
unnamed: CAMERA_FUSE.2, CAMERA_REG.ON/OFF, CAMERA_REG.VOUT
VBATT: BATTERY.PLUS, MOTOR_FUSE.1A
VCC: CAMERA_REG.VIN, CIN.1, CPU_REG.INPUT, MICRO_REG.INPUT, MOTOR_DRIVER.PLUS, MOTOR_FUSE.2A, MOTOR_LED.A, R5.1, SYS_DIODE.ANNODE
