SpaceJockey/MRSD-Team-B/Project/Task10/powerdist2.sch

## EAGLE design Project/Task10/powerdist2.sch (2013-10-22)

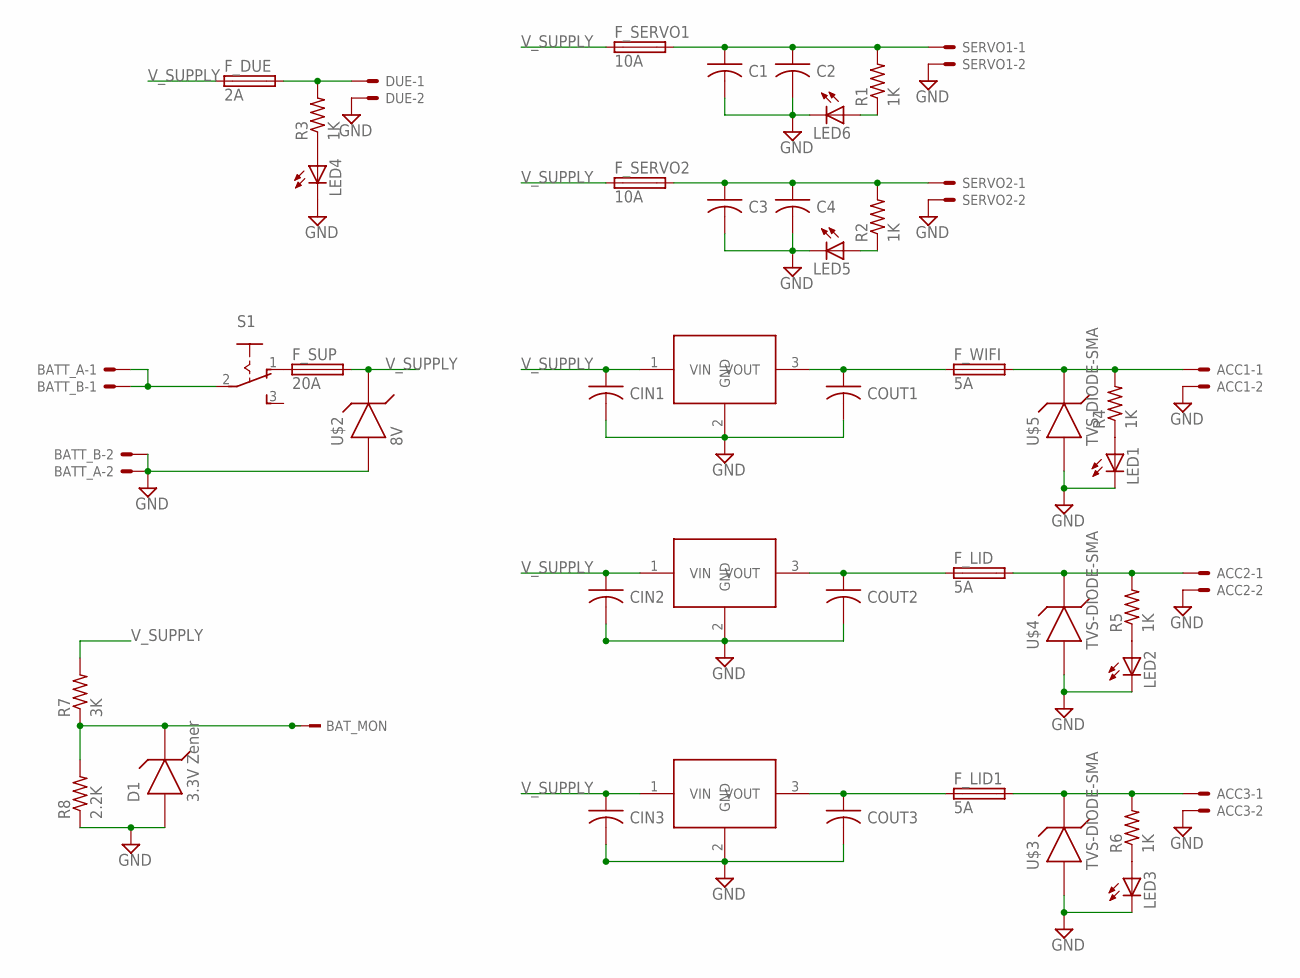
[picture p38: schematic powerdist2.sch]

Parts:
ACC1: C-GRID-02-70553; 70553-02
ACC2, ACC3: 5566-2
BATT_A: 22-23-2021
BATT_B: 22-23-2021
BAT_MON: TSW-101-02-S-S
C1, C2, C3, C4: CAPACITORTH_CAP; C025-025X050
CIN1, CIN2, CIN3: CAPACITORTH_CAP; C025-025X050
COUT1, COUT2, COUT3: CAPACITORTH_CAP; C025-025X050
D1: 3.3V Zener; SMA
DUE: C-GRID-02-70553; 70553-02
F_DUE: 2A; GSH15
F_LID, F_LID1: 5A; GSH15
F_SERVO1, F_SERVO2: 10A; GSH15
F_SUP: 20A; GSH15
F_WIFI: 5A; GSH15
LED1, LED2, LED3, LED4, LED5, LED6: LEDCHIP-LED0805; CHIP-LED0805
R1, R2, R3, R4, R5, R6: 1K; 0309/10
R7: 3K; 0309/10
R8: 2.2K; 0309/10
S1: 255SB
SERVO1, SERVO2: 5566-2
U$1, U$6, U$7: MIC29150/29300/29500; TO220
U$2: 8V; SMA
U$3, U$4, U$5: TVS-DIODE-SMA; SMA

Connections:
GND: ACC1.2, ACC2.2, ACC3.2, BATT_A.2, BATT_B.2, C1.2, C2.2, C3.2, C4.2, CIN1.2, CIN2.2, CIN3.2, COUT1.2, COUT2.2, COUT3.2, D1.AN, DUE.2, LED1.C, LED2.C, LED3.C, LED4.C, LED5.C, LED6.C, R8.1, SERVO1.2, SERVO2.2, U$1.2 (GND), U$2.AN, U$3.AN, U$4.AN, U$5.AN, U$6.2 (GND), U$7.2 (GND)
unnamed: C3.1, C4.1, F_SERVO2.2, R2.2, SERVO2.1
unnamed: ACC2.1, F_LID.2, R5.2, U$4.CAT
unnamed: DUE.1, F_DUE.2, R3.2
unnamed: LED6.A, R1.1
unnamed: COUT1.1, F_WIFI.1, U$7.3 (VOUT)
unnamed: ACC1.1, F_WIFI.2, R4.2, U$5.CAT
unnamed: LED5.A, R2.1
unnamed: COUT2.1, F_LID.1, U$6.3 (VOUT)
unnamed: BATT_A.1, BATT_B.1, S1.2
unnamed: LED4.A, R3.1
unnamed: LED1.A, R4.1
unnamed: F_SUP.1, S1.1 (O)
unnamed: C1.1, C2.1, F_SERVO1.2, R1.2, SERVO1.1
unnamed: LED2.A, R5.1
unnamed: BAT_MON.1, D1.CAT, R7.1, R8.2
unnamed: COUT3.1, F_LID1.1, U$1.3 (VOUT)
unnamed: ACC3.1, F_LID1.2, R6.2, U$3.CAT
unnamed: LED3.A, R6.1
V_SUPPLY: CIN1.1, CIN2.1, CIN3.1, F_DUE.1, F_SERVO1.1, F_SERVO2.1, F_SUP.2, R7.2, U$1.1 (VIN), U$2.CAT, U$6.1 (VIN), U$7.1 (VIN)
