SpaceJockey/MRSD-Team-B/(commit log)

2013-10-03 Added Task 5 Files
    Validated and Edited Diptas Version, corrected Packaging problems and
    renamed the library...
    [TeamB.brd, TeamB.sch]
2013-10-03 Corrected Packages, Verified Trace widths
    Used TE5 fuses, and verified everything using 1 oz copper
    [TeamB.brd, TeamB.sch]
2013-10-04 Incorporated Songjie & Dipta's work for tasks 5&6
    [TeamB.slddrw, TeamB.sldprt]
2013-10-07 force sensor to control DC motor
2013-10-09 DC Motor Speed Control
    Speed control
2013-10-09 Fixed Arduino Packet parsing
2013-10-09 Motor Position Control
    Motor Position Control
2013-10-09 DC Motor Speed Control
2013-10-09 DC Motor Position Control
2013-10-09 Motor Control Functions ready for motor hookup
2013-10-09 Started adding Motor Speed/Position controllers
2013-10-09 Added encoder code (placeholder channel number)
2013-10-09 Started clean motor driver testbed
2013-10-09 Button with debounce
2013-10-09 Fixed Stepper Driver
2013-10-09 More stepper work
2013-10-09 Reverted pressure and range sensor smoothing (wasnt working)
    Not bad on the potentiometer though
2013-10-11 Refactored, added task 6 release tags, PDR folder
    [TeamB.brd, TeamB.sch, TeamB.slddrw, TeamB.sldprt]
2013-10-21 Task 10 Schematic Draft
    [powerdist2.brd, powerdist2.sch]
2013-10-21 For voltage monitoring, I used a single header pin
    [powerdist2.brd, powerdist2.sch]
2013-10-21 Updated power distribution board schematic
    [powerdist2.brd, powerdist2.sch]
2013-10-22 Updated Schematic, ready for submitting...
    [powerdist2.brd, powerdist2.sch]
2013-10-22 Downloaded the Adafruit I2C Servo Library
2013-10-24 Task 10- Chose R, C, LED pkg, started BOM
    [PDM.sch, powerdist2.brd]
2013-10-24 Fixed diode packages and symbols
    [PDM.sch]
2013-10-24 Updated BOM
2013-10-28 Added PDR and Sketchup Resources
    [Arduino UNO Rev.skp, Jockey-MidJoint.skp, PDM.sch, ServoCity Linear Actuator.skp, Use Case.skp, WalkingAnim.blend, servo.skp]
2013-10-28 Changed TO-220 Package to Horizontal
    [PDM.sch]
2013-10-28 Added ATO Fuseholders, Spec'd main switch
    Moved main power switch/EStop to Batt harness (No PCB-Mount 20A switches
    available).
    [PDM.sch]
2013-10-28 ERC Errors Corrected
    Several lines were not connected. Fixed.
    [PDM.sch]
2013-10-28 Board for PDB Created
    [PDM.brd]
2013-10-28 Datahseet for XT60 for battery connector added
    [PDM.brd, PDM.sch]
2013-10-28 Library for XT60 Connector Started
2013-10-29 Added Hydro ros_lib to Arduino sketchbook
2013-10-29 Main Switch for Power from battery. It can handle 20A
2013-10-29 Fixed Capacitors and Schematic
    [PDM.brd, PDM.sch]
2013-10-29 Schematic and Board Updated
    Schematic is updated with Battery Port XT60 and Caps.
    Board is updated with basic placement, not yet routed
    [PDM.brd, PDM.sch]
2013-10-30 Datasheet for Power Switch 20A
    [PDM.brd]
2013-10-30 Power Distribution Board Done, minus Power Switch
    Mostly board design is done. Just need to add power switch.
    The trace width is 423 mil, as calculated by the web
    http://circuitcalculator.com/wordpress/?p=25/ , in order to deliver
    current of 20A.
    [PDM.brd, PDM.sch]
2013-10-30 E-SWITCH STARTED
    LIBRARY E-SWITCH started. will be continued tomorrow
2013-10-30 More PDM work
    [PDM.brd, PDM.sch]
2013-10-30 Final Board Revision
    [PDM.brd]
2013-10-30 BOM Started
    [BOM.xlsx]
2013-10-30 Final Board design.
    Looks good. I just moved the giant capacitors one grid to the left to
    enlarge the clearance with the ground
    [PDM.brd, PDM.sch]
2013-10-30 Task 10 ready to submit
    [BOM.xlsx, PDM.brd, PDM.sch, PDM_BOM.csv, PDM_BOM.ods, PDM_BOM.xlsx]
2013-11-01 Imported the Arduino DUE Shield from GDrive
    [Arduino DUE Shield.brd, Arduino DUE Shield.sch]
2013-11-03 Added Minifit Jr. to BOM
    [PDM_BOM.xlsx]
2013-11-04 Added some solidworks parts for stock McMaster components
    [6383K213.SLDPRT, 6383K234.SLDPRT, 6455K130.SLDPRT, 6455K230.SLDPRT, 94639A203.SLDPRT]
2013-11-05 Added more stock parts
    [1570K420.SLDPRT, 5986K68.SLDPRT, 5986K767.SLDPRT, 6383K213.SLDPRT, 6383K234.SLDPRT, 6455K130.SLDPRT, 6455K230.SLDPRT, 94639A203.SLDPRT]
2013-11-05 Exported Arduino Drill pattern for reuse
    [ArduinoMega.SLDPRT]
2013-11-05 Added Servo Drill Pattern
2013-11-06 Linear Actuator & Stock Parts library fleshed out
    [1570K420.SLDPRT, 7854K12.SLDPRT, 94639A203.SLDPRT, 97431A340.SLDPRT, 9968K24.SLDPRT, Actuator.SLDASM, ArduinoMega.SLDPRT, Bearing Bulkhead B.SLDPRT]
2013-11-11 Refactored Linear Actuator Assemblies
    [3547S-1AA-502A-ND.SLDPRT, 5986K68.SLDPRT, 5986K767.SLDPRT, 6-32-BallJoint.SLDPRT, 7854K12.SLDPRT, 93286A007.SLDPRT, 93505A440.SLDPRT, 93505A444.SLDPRT]
2013-11-11 Started Space Jockey Assembly
    [6455K130.SLDPRT, 7854K12.SLDPRT, 98511A322.SLDPRT, Actuator.SLDASM, Fixed Rot Blank.SLDPRT, Fixed Top.sldprt, PotGear.SLDPRT, RackShaft.SLDASM]
2013-11-11 Oh yeah, it's all coming together...
    [94639A569.SLDPRT, Actuator.SLDASM, End Rot Blank.SLDPRT, End Top.sldprt, Fixed Rot Blank.SLDPRT, Fixed Top.sldprt, RotJoint Blank.SLDPRT, Space Jockey.SLDASM]
2013-11-11 Not sure if this broke stuff yet, but laser plan
    [Actuator Laser Cut.SLDASM, Actuator Laser Cut.SLDDRW, Actuator.SLDASM, Space Jockey LaserCut.SLDASM, Space Jockey.SLDASM]
2013-11-11 Fined-Tuned Laser cut stuff
    and started correcting dry-fit issues
    [Actuator Laser Cut.SLDASM, Actuator Laser Cut.SLDDRW, Actuator.SLDASM, Fixed Rot Blank.SLDPRT, Fixed Top.sldprt, RotJoint Blank.SLDPRT, Space Jockey LaserCut.SLDASM, Top Block.sldprt]
2013-11-16 Updated Solidworks to begin assembly
    [1570K420.SLDPRT, 5986K68.SLDPRT, 5986K767.SLDPRT, 6-32x3in allthread.SLDPRT, 7854K12.SLDPRT, 97431A340.SLDPRT, 9968K24.SLDPRT, Actuator.SLDASM]
2013-11-19 Designed Center Segment
    Laser Cut V.1.2 + Arduino Calibration scripts
    [6455K230.SLDPRT, 93505A440.SLDPRT, 99223A067.SLDPRT, Actuator.SLDASM, Ball Joint.SLDPRT, Bearing Bulkhead.SLDASM, Center Ball Joint.SLDPRT, Center Bulkhead.sldprt]
2013-11-23 Added Arduino Code
2013-11-23 added ROS src code
    [spacejockey.urdf]
2013-11-23 Servo Calibration Done, Draft ROSListener written
    Just waiting for Brian to figure our ROSSerial...
2013-11-24 Battery Monitoring
    Using analog reading from pin A0.
    Battery 100% ==> 8.5V
    Battery 0% ==> 6V
    Convert to percentage and give alert if battery less than 20%
2013-11-24 Battery Monitoring update
    LED (pin 12) will turn on if the battery less than 7.5V
2013-11-24 Added Battery Monitoring to ROSListener
2013-11-24 updated independent battery monitoring code
    this is separated code, won't effect on the main code
    [batterymonitoring.ino]
2013-11-27 Thinned out Linear Actuators, started Chassis 2.0
    [Actuator.SLDASM, Bearing Bulkhead.SLDASM, Bulkhead Blank.SLDPRT, Fixed Rot Blank.SLDPRT, Fixed Top.sldprt, RotJoint Blank.SLDPRT, Shaft Bulkhead.SLDASM, Space Jockey.SLDASM]
2013-12-01 Refactored Stock Parts and added ServoCity Mount
    with the CAD assignment finished, in-house vs McMaster file origins no
    longer matters.
    [3547S-1AA-502A-ND.SLDPRT, 5986K68.SLDPRT, 5986K767.SLDPRT, 6-32-BallJoint.SLDPRT, 6-32x3in allthread.SLDPRT, 7854K12.SLDPRT, 9968K24.SLDPRT, BrassBushing.SLDPRT]
2013-12-03 Updated battery monitoring & servo pinout
2013-12-03 Added Servo Calibration script
2013-12-04 Got digital servo control working...
2013-12-04 Updated digital calibration values for the robot
2013-12-06 Changed bootup order and fixed ROS yeild issue
    [ROSListener.ino]
2013-12-06 Started scaling the center segment
    [Center Bulkhead.sldprt, Center Segment.SLDASM, Center-RotJoint-Blank.SLDPRT, Middle-Top 1.sldprt]
2014-01-16 Current SW Design
    [Actuator.SLDASM, Center Ball Joint.SLDPRT, Center Bulkhead.sldprt, Center Segment.SLDASM, Center-RotJoint-Blank.SLDPRT, Hitec HS-5496.SLDPRT, Middle-Top 1.sldprt, ServoGrommet.SLDASM]
2014-01-20 Restructured Repository
    Moved all Fall Semester Tasks & Business stuff to GDrive. Deleted Cruft,
    moved project stuff down a level...
    [1570K420.SLDPRT, 3547S-1AA-502A-ND.SLDPRT, 5986K68.SLDPRT, 5986K767.SLDPRT, 6-32-BallJoint.SLDPRT, 6-32x3in allthread.SLDPRT, 6383K213.SLDPRT, 6383K234.SLDPRT]
2014-01-20 still merging...
    [3547S-1AA-502A-ND.SLDPRT, 5986K68.SLDPRT, 5986K767.SLDPRT, 6-32-BallJoint.SLDPRT, 6-32x3in allthread.SLDPRT, 7854K12.SLDPRT, 9968K24.SLDPRT, BrassBushing.SLDPRT]
2014-01-20 Final Merge Complete
    [3547S-1AA-502A-ND.SLDPRT, 5986K68.SLDPRT, 5986K767.SLDPRT, 6-32-BallJoint.SLDPRT, 6-32x3in allthread.SLDPRT, 7854K12.SLDPRT, 9968K24.SLDPRT, BrassBushing.SLDPRT]
2014-01-28 temp commit
    [Space Jockey.SLDASM]
2014-01-30 Camera Trade Studies and Comparing image Python
    [Camera Trade Studies.xlsx]
2014-01-30 IMU Trade Studies and Simplified PDM
    [IMU Trade Studies.xlsx, PDM.brd, PDM.sch, PDM_BOM.csv, PDM_BOM.ods, PDM_BOM.xlsx]
2014-01-30 Python Image Comparison
    [PDM.brd]
2014-01-30 Updated PDM
    1 Power Supply channel
    1 servo channel
    1 camera channel
    [Camera Trade Studies.xlsx, PDM.brd, PDM.sch]
2014-02-04 Miniaturized PDM
    [PDM.brd, PDM.sch]
2014-02-08 Finalized PCB for fab
    [PDM.brd]
2014-02-08 Added Parameterized Gear template
    [ParamGear.SLDPRT]
2014-02-08 Started Plastic Fantastic Redesign
    [1257K650.SLDPRT, 5986K66.SLDPRT, 5986K68.SLDPRT, 7854K12.SLDPRT, Actuator.SLDASM, FixedEnd.SLDPRT, RackShaft.SLDASM, ServoGear.SLDPRT]
2014-02-13 Removed Laser-Cut Components + added ABS Housings
    [1257K650.SLDPRT, Actuator.SLDASM, Bearing Bulkhead.SLDASM, Bulkhead Blank.SLDPRT, Fixed Rot Blank.SLDPRT, Fixed Top.sldprt, FixedEnd.SLDASM, FixedEnd.SLDPRT]
2014-02-13 Removed Old PDM, Gerbers added, ready for BOM
    [Arduino DUE Shield.brd, Arduino DUE Shield.sch, PDM.brd, PDM.sch, PDM_BOM.csv, PDM_BOM.ods, PDM_BOM.xlsx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]
2014-02-13 Updated BOM, ready for Digi-Key Order
    [PDM_BOM.ods, PDM_BOM.xlsx]
2014-02-13 Rebuilt Rosserial-arduino libraries
2014-02-13 arduino debug topic
2014-02-13 Fixed Wiring doc regression
    [ROSListener.ino]
2014-02-13 Fixed Regressions in rosserial_arduino
    [ROSListener.ino]
2014-02-13 Added regression fix comment
    https://github.com/ros-drivers/rosserial/issues/85
2014-02-16 Finished Fixed-End Redesign
    [Actuator.SLDASM, Bottom.sldprt, FixedEnd.SLDASM, FixedEnd.SLDPRT, FixedEndJoin.SLDASM, FixedEndJoin.sldprt, FixedEndSplit.sldasm, Top.sldprt]
2014-02-16 Began playing with planner prototype
2014-02-18 Fix Arduino Hole tolerance issue
    [FixedEnd.SLDPRT]
2014-02-18 Fixed the ROSListener Bug
    [ROSListener.ino]
2014-02-18 Refactored Battery and Debug Code
    TODO: Servo control code
2014-02-19 Fixed Bearing tolerance issue
    [FixedEnd.SLDPRT]
2014-02-21 Split ROS functionality from Servo Functionality
2014-02-23 Finished Arduino code refactor; ready for testing.
2014-02-23 Fixed Rotary Joint tolerance issues
    rebuilt linear actuator production parts
    [Actuator.SLDASM, Bottom.sldprt, CenterStub.SLDPRT, FixedEnd.SLDPRT, FixedEndJoin.SLDASM, FixedEndJoin.sldprt, Top.sldprt, TrimmedShaft.SLDDRW]
2014-02-24 started work on free end of linear actuator
    [FreeEnd.SLDPRT]
2014-03-01 IMU code for MPU6050 IMU code for MPU6050
2014-03-03 this is not going so well
    [CenterJoint2.SLDPRT]
2014-03-04 pulled in Dipta's IMU code to prototypes
2014-03-04 refactored IMU code for readability
2014-03-04 Removed Debug thread
    ported debug functions to built-in rosserial logging
2014-03-04 Fixed Arduino bugs, ready for merge to master
    [Battery.h, SpaceJockey.h, SpaceJockey.ino]
2014-03-04 Renamed joint control topic
2014-03-06 Finished Center Segment Design
    [Ball Joint.SLDPRT, Center Ball Joint.SLDPRT, Center Bulkhead.sldprt, Center Segment.SLDASM, Center-RotJoint-Blank.SLDPRT, Center-Strength.sldprt, CenterJoin.SLDASM, CenterJoin.sldprt]
2014-03-06 Mirrored backwards components
    [Actuator.SLDASM, CenterJoinA.sldprt, CenterJoint.SLDASM, CenterJointA.SLDPRT, CenterJointB.SLDPRT, Space Jockey.SLDASM]
2014-03-07 Repositioned Power switch mount
    added chamfers to solve cracking problem
    [CenterJoinA.sldprt, CenterJoint.SLDASM, CenterJointA.SLDPRT, Space Jockey.SLDASM]
2014-03-07 Added bearing/shaft supports to CenterJointA
    [CenterJoinA.sldprt, CenterJoint.SLDASM, CenterJointA.SLDPRT]
2014-03-09 fixed step movement planning, added prints emulating ROS output
2014-03-09 Started working on my chassis revision list
    TODO: fixe servo mount hole sizes, design feet, add walls to battery
    box.
    [Actuator.SLDASM, BatteryBox.SLDASM, BatteryBox.SLDPRT, CenterJoinA.SLDASM, CenterJoinA.sldprt, CenterJoint.SLDASM, CenterJointB.SLDPRT, FixedEndJoin.SLDASM]
2014-03-09 Removed old planner prototype
    now resides in ROS/src/spacejockey
2014-03-10 Added MakerBot standard profile, added test parts
    [6-32-size.SLDPRT, JointStub.SLDPRT, SparkFunBattery.SLDPRT]
2014-03-10 Propagating servo mount changes through design.
    Working on issue #8
    [BatteryBox.SLDASM, BatteryBox.SLDPRT, CenterJoinA.SLDASM, CenterJoinA.sldprt, CenterJoint.SLDASM, CenterJointA.SLDPRT, CenterJointB.SLDPRT]
2014-03-10 Fixed all servo mounts.
    fixes #8
    [Actuator.SLDASM, BatteryBox.SLDPRT, Bottom.sldprt, CenterJoinA.SLDASM, CenterJoinA.sldprt, CenterJoint.SLDASM, CenterJointB.SLDPRT, FixedEnd.SLDPRT]
2014-03-11 Moved trade studies to Google Drive
    [Camera Trade Studies.xlsx, IMU Trade Studies.xlsx]
2014-03-12 Fixed Servo Tolerances... again
    Layer separation and cracking problems n servo mounts
    [Bottom.sldprt, CenterJoinA.SLDASM, CenterJoinA.sldprt, CenterJoint.SLDASM, CenterJointA.SLDPRT, CenterJointB.SLDPRT, FixedEnd.SLDPRT, FixedEndJoin.SLDASM]
2014-03-17 got turning working, respecting joint limits.
2014-03-24 Started developing stub foot model
    [Actuator.SLDASM, CenterJoint.SLDASM, EndFoot.SLDPRT, FixedEndJoin.SLDASM, FixedEndJoin.sldprt, Space Jockey.SLDASM]
2014-03-27 Changed joint ctl messages to 32 bit accuracy
2014-03-27 Got IMU prototype code compiling...
2014-03-28 Added new urdf
    [spacejockey.urdf]
2014-03-28 added RViz to launch files
    [spacejockey.urdf]
2014-03-28 moved URDF to spacejockey/resources
    [spacejockey.urdf]
2014-03-28 added joint state publisher to launch file and renamed foot locs to match planner defs
    [spacejockey.urdf]
2014-03-28 added camera transform publisher
    [spacejockey.urdf]
2014-03-28 started kinematics submodule
2014-03-30 added python URDF parser, prototyped kinematics functions
2014-03-31 Minor improvements to center joint.
    [CenterJoinA.SLDASM, CenterJoinA.sldprt, CenterJointA.SLDPRT]
2014-03-31 added camera transform to URDF
    [spacejockey.urdf]
2014-03-31 New urdf
    [spacejockey_2.urdf]
2014-03-31 merged brian's URDF changes
    [spacejockey.urdf, spacejockey_2.urdf]
2014-04-01 Convert the value to g/100 unit
    When the sensor is placed perfectly leveled with the ground, the value
    of x/y is 0, and the value of z is +16384 at a sensitivity of 2g. In
    order to get the real value, we have to multiplied it by 1g/16384.
    I divided it by 164 to make it in g/100 unit
2014-04-01 End foot and peg for detachment
    [EndFoot.SLDPRT, TriPeg.SLDPRT]
2014-04-02 got IMU prototype code ready for integration
2014-04-02 Integrated accelerometer with Due Firmware
2014-04-02 added detach joint stubs to URDF file
    [spacejockey.urdf]
2014-04-02 added detach joints to Arduino Code
2014-04-03 fixed joint order and urdf dimensions
    [spacejockey.urdf]
2014-04-03 bedtime commit
    [spacejockey.urdf]
2014-04-03 fixed control_bridge joint ordering
    [spacejockey.urdf]
2014-04-03 reorganized urdf to match planner
    [spacejockey.urdf]
2014-04-04 selectively merged feature_image_pipeline
    [spacejockey_2.urdf]
2014-04-04 End and center feet Updated param gear servo to reflect our current standard (.75)
    [CenterFoot.SLDASM, EndFoot.SLDPRT, ParamGearServo.SLDPRT, ScrewStub.SLDPRT]
2014-04-05 Extended actuators to avoid clearance issue
    [Actuator.SLDASM, Bottom.sldprt, CenterJoint.SLDASM, FixedEnd.SLDPRT, FixedEndJoin.SLDASM, FixedEndJoin.sldprt, FreeEnd.SLDPRT, FreeEndJoin.SLDASM]
2014-04-05 first pass at updating arduino code to take pwm values
2014-04-06 started modifying calibration code for smaller footprint and preemption support
2014-04-08 added heartbeat monitor to prototype code
2014-04-09 finished Arduino side rewrite
2014-04-09 Rewrote ROS side and control bridge
    [spacejockey.urdf]
2014-04-09 updated control_bridge to read joint limits from URDF
2014-04-09 fixed unused attach joints
    [spacejockey.urdf]
2014-04-09 IK engine now respects joint limits
2014-04-09 Fixed Actuator Tolerance problem
    [Actuator.SLDASM, FixedEnd.SLDPRT, FixedEndJoin.SLDASM, FixedEndJoin.sldprt, FreeEndJoin.SLDASM, Top.sldprt]
2014-04-09 Cleaned up repository
    Moved obsolete stuff to Google Drive
    [Arduino UNO Rev.skp, Jockey-MidJoint.skp, ServoCity Linear Actuator.skp, servo.skp]
2014-04-10 Fixed Servo mount spline and removed boss
    [ParamGearServo.SLDPRT]
2014-04-10 Fixed linear gear tolerance (again)
    [FixedEnd.SLDPRT, FixedEndJoin.SLDASM, FixedEndJoin.sldprt, Top.sldprt]
2014-04-10 messin with frames
    [spacejockey.urdf]
2014-04-12 updated URDF to be compliant with axis conventions see part 3 here: http://wiki.ros.org/Industrial/Tutorials/Create%20a%20URDF%20for%20an%20Industrial%20Robot
    [spacejockey.urdf]
2014-04-12 got test ik framework working...
2014-04-12 rolled kinematics into core module
2014-04-14 New Feet!
    new center foot, new end foot, camera mount version of end foot as well
    [CameraFoot.SLDPRT, CenterFoot.SLDASM, EndFootB.SLDPRT]
2014-04-14 rolled planner stuff into main launch file
    [spacejockey.urdf]
2014-04-14 manually merged Dipta's broken branch
    [calibration.yaml]
2014-04-15 Added spacecam, works with AR Track
    [calibration.yaml]
2014-04-15 Fixed spacecam, adding vision_opencv and camera_info_manager, which is crucial for spacecam project
    [test_calibration.yaml]
2014-04-15 joint vels
    [spacejockey.urdf]
2014-04-15 removed old modules
    [test_calibration.yaml]
2014-04-15 fixed syntax errors
    [spacejockey.urdf]
2014-04-15 demo code
    [spacejockey.urdf]
2014-04-16 added dipta's externalized webcam driver
2014-04-18 updated marker tag size to match magnetic tags.
2014-04-19 Added battery status indicator fixes #18
2014-04-21 Camera foot update
    fixes #22
    [CameraFoot.SLDPRT]
2014-04-21 Implemented rough view angles in IK fixes #12 Still TODO: pull IK params from URDF
2014-04-21 Camera URDF
    Corrected camera in urdf
    [spacejockey.urdf]
2014-04-23 Fix the link for the camera
    Fix the url format for camera. Some characters such as '&' and '"' should be written in XML Dec Reference
2014-04-24 prototyped localization code
2014-04-27 moved battery calibration values into ROS
2014-04-27 added vignetting, better mixing working on #30 I chose to use an image for the vignette as opposed to a math definition because that makes it easier to set up complicated filters if we want to...
2014-04-27 Newest feet
    [CameraFoot.SLDPRT, CameraMount.SLDPRT, CenterFoot.SLDASM, EndFoot.SLDPRT, EndFootB.SLDPRT, Peg4.SLDPRT, ScrewStub.SLDPRT, TriPeg.SLDPRT]
2014-04-28 Battery monitor calibrationn
    Fixes #26
2014-04-28 Recalibrated feet, swivel joint (was way off)
    Fixes #20
    [spacejockey.urdf]
2014-04-29 fixed camera warp orientation
2014-04-29 added camera target offset to inverse kinematics
2014-04-29 added urdf parsing to IK, mad it throw exceptions when misused
2014-04-30 cleaned up arduino wiring
2014-04-30 Updated calibration
    [spacejockey.urdf]
2014-04-30 added gaussian filtering to flaw detection
2014-05-01 commented IMU out of firmware
2014-05-01 Calibration Update
    [spacejockey.urdf]
2014-05-07 Updated Space Jockey Assembly
    to get images for final paper
    [Actuator.SLDASM, CenterFoot.SLDASM, CenterJoint.SLDASM, Space Jockey.SLDASM, SparkFunBattery.SLDPRT]
2014-05-08 removed old stock parts
    [1091-1013-ND.SLDPRT, 1257K650.SLDPRT, 1570K420.SLDPRT, 3547S-1AA-502A-ND.SLDPRT, 5986K66.SLDPRT, 5986K68.SLDPRT, 5986K767.SLDPRT, 6-32-BallJoint.SLDPRT]
2014-05-08 submodularized stock parts from MRSD-library
    [Actuator.SLDASM, BatteryBox.SLDASM, CenterJoint.SLDASM, FreeEndJoin.SLDASM, ParamGear.SLDPRT, RackShaft.SLDASM, Space Jockey.SLDASM]
